arnavwx/Analog-Quadrature-Down-Converter/docs/images/lab_pictures/06_Oscillator_Output_Lab.png

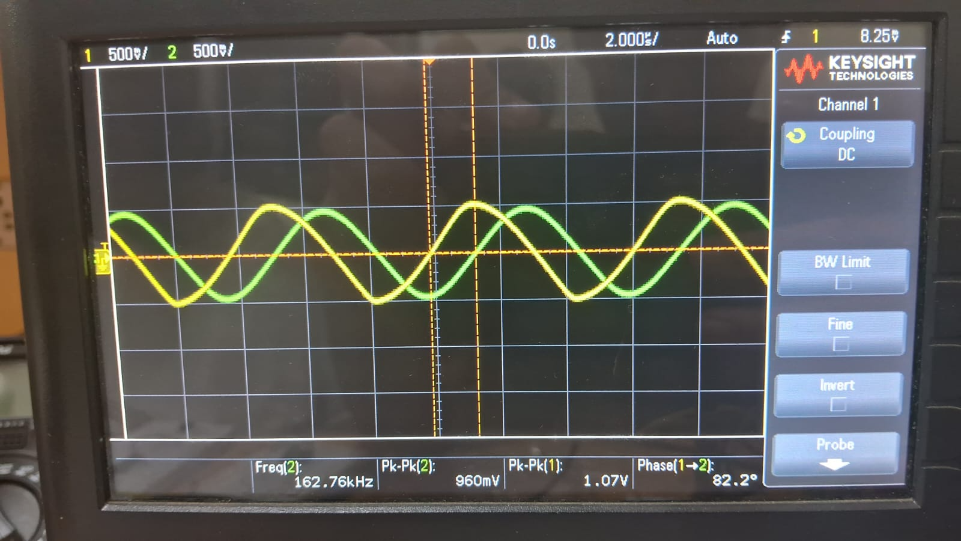
docs/images/lab_pictures/06_Oscillator_Output_Lab.png
