arnavwx/Analog-Quadrature-Down-Converter/theory/01_Direct_Conversion_Architecture.md

# Direct-Conversion (Zero-IF) Architecture

## Overview
The Direct-Conversion Receiver (DCR), also known as Homodyne, Zero-IF, or Synchrodyne architecture, is a radio receiver design that demodulates an incoming radio frequency (RF) signal using a local oscillator (LO) whose frequency is identical (or very close) to the carrier frequency of the intended signal.

Unlike a Superheterodyne receiver, which steps down the high-frequency RF signal into an intermediate frequency (IF) before baseband processing, a Direct-Conversion receiver translates the RF signal directly down to baseband (0 Hz) in a single step.

## Advantages of Direct Conversion
1. **No Image Frequency**: Because the IF is zero, the image frequency is the RF signal itself. This eliminates the need for bulky and expensive image-reject filters (IRF) placed before the mixer.
2. **High Integration**: All channel selection filters can be low-pass filters instead of band-pass filters. Low-pass filters are much easier to integrate onto a silicon CMOS chip, leading to highly miniaturized System-on-Chip (SoC) transceivers (like those in modern smartphones and IoT devices).
3. **Cost and Power Efficiency**: Removing the off-chip SAW filters and secondary IF stages significantly cuts down the bill of materials (BOM), manufacturing cost, and power consumption.

## Why Quadrature (I/Q) Downconversion?
When an RF signal is mixed directly down to 0 Hz, the upper and lower sidebands of the RF signal fold on top of each other at baseband. If the signal is phase- or frequency-modulated (e.g., QAM, QPSK), mixing with a single LO will irretrievably scramble the sidebands together, destroying the information.

To separate the sidebands, we must use **Quadrature Downconversion**. The RF signal is split and fed into two parallel mixers:
- **I (In-phase) Mixer**: Driven by $LO \cdot \cos(\omega t)$
- **Q (Quadrature) Mixer**: Driven by $LO \cdot \sin(\omega t)$ (a $90^\circ$ phase shift)

By processing both the I and Q channels, the digital backend (DSP) can perfectly reconstruct the complex signal vector and separate the folded sidebands.

## Key Design Challenges
1. **DC Offsets**: Since the signal is downconverted to DC (0 Hz), any LO leakage into the RF port that mixes with itself creates a massive DC spike. This can saturate the baseband amplifiers.
2. **I/Q Mismatch**: If the LO paths do not have exactly $90^\circ$ of phase shift, or if the two mixers have slightly different gains, the resulting constellation diagram will be distorted, degrading the Bit Error Rate (BER).
3. **Flicker Noise (1/f Noise)**: CMOS transistors exhibit high 1/f noise at low frequencies. Since the baseband signal sits near DC, it must compete with the high flicker noise of the mixer and subsequent amplifiers.
