arnavwx/Analog-Quadrature-Down-Converter/Final_Submission_Report.pdf

# Quadrature Down Converter

Analog Electronic Circuits (EC2.103) — Spring 2026, IIIT Hyderabad

Parth Tehlan
International Institute of Information Technology Hyderabad, India
2025102041

Arnav Jain
International Institute of Information Technology Hyderabad, India
2025102030

Navya Upadhyay
International Institute of Information Technology Hyderabad, India
2025112019

Abstract—This paper presents the complete design, analysis, and LTspice simulation of a Quadrature Down Converter (QDC) for the Analog Electronic Circuits course project (Spring 2026). The system comprises three tightly integrated subsystems:a UA741-based quadrature oscillator with 1N4148 diode amplitude stabilization operating at 150 kHz, dual NMOS switching mixers (TSMC 180 nm, W = 10 µm), and RC low-pass filters with a −3 dB cutoff of ≈ 3.39 kHz followed by an output amplifier stage. The oscillator generates two quadrature sinusoidal LO signals (vOSCI and vOSCQ) with a 90◦
phase difference. Each
NMOS mixer multiplies the 100 mV RF input with the respective LO signal, producing IF components. After low-pass filtering, the final I and Q outputs at fIF = |fosc −fin| maintain a 90◦ phase
difference, confirming successful quadrature downconversion. Index Terms—quadrature down converter, QDC, NMOS mixer, quadrature oscillator, UA741, TSMC 180nm, downconversion, low-pass filter, IQ demodulation
I. INTRODUCTION AND NEED FOR QUADRATURE DOWNCONVERSION (Q1)
A. Motivation
In modern wireless receivers (Bluetooth, Wi-Fi, WLAN), a high-frequency RF signal vin = A1 cos(ωint) must be translated to a lower intermediate frequency (IF) for practical baseband processing. Simple real-valued downconversion by multiplying with a single LO produces:

vin·cos(ωosct) = A1
2

[cos((ωin − ωosc)t) + cos((ωin + ωosc)t)] (1)

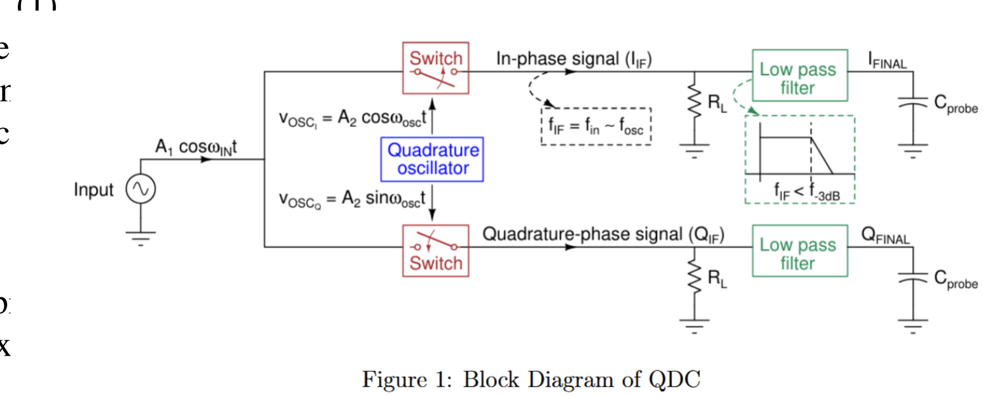
[picture p2: figure]

Both the desired signal at ωin − ωosc and its image at ωosc − ωin are indistinguishable, causing image interference. Furthermore, for asymmetrically modulated signals downconverted to zero-IF, the signal can interfere with itself.

B. Quadrature Solution
A QDC solves this by generating two orthogonal LO copies: vOSCI = A2 cos(ωosct) and vOSCQ = A2 sin(ωosct). Mixing produces:

vIF I = vin·vOSCI =

A1A2
2

[cos(ωint − ωosct) + cos(ωint + ωosct)] (2)

vIF Q = vin·vOSCQ =

A1A2
2

[sin(ωint + ωosct) − sin(ωint − ωosct)] (3)
After low-pass filtering, the IF components at ωIF = ωIN − ωOSC are retained. Because vIF I contains cos(ωIF t) and vIF Q contains − sin(ωIF t), the two outputs are inherently 90◦ out of phase. The complex baseband signal vIF I +jvIF Q fully characterizes the original RF signal’s amplitude and phase, enabling image rejection and complete demodulation [?] [?].
For example, with fIN = 2.4 GHz and fOSC = 2.401 GHz, one obtains fIF = 1 MHz — a manageable baseband frequency.

II. SYSTEM ARCHITECTURE
The complete QDC block diagram is shown in Fig. 1. The RF input enters two parallel switch-mixer branches. A shared quadrature oscillator feeds vOSCI (cosine) to the Ibranch mixer and vOSCQ (sine) to the Q-branch mixer. Each mixer output passes through a low-pass filter and amplifier to yield the final IF INAL and QF INAL outputs. The LTspice simulation uses the following directives:

.tran 0 1m 0 10u
.inc UA741.301
.inc TSMC_180nm.txt
.param width=10u

Fig. 1. Block diagram of the Quadrature Down Converter.

III. QUADRATURE OSCILLATOR DESIGN (Q2)

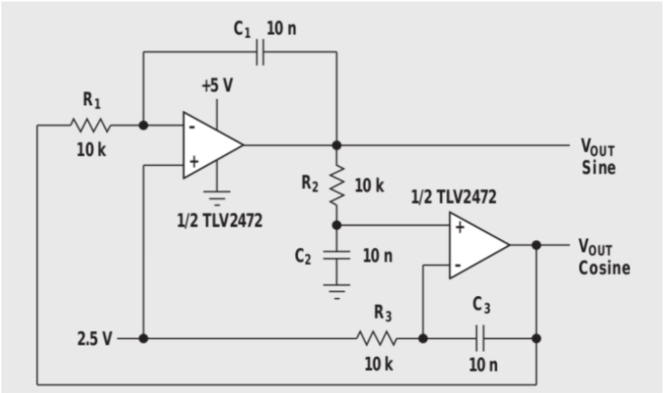
[picture p3: figure]

Fig. 2. Schematic of the quadrature oscillator.

A. Topology

The quadrature oscillator uses two UA741 op-amps (U1, U2) in a two-integrator feedback loop. Six 1N4148 diodes (D1–D6) arranged in back-to-back pairs provide soft amplitude limiting, ensuring a stable 1 VP P output without saturation distortion. The supply voltages are VDD = +12 V and VSS = −12 V for the UA741 op-amps, consistent with their rated supply range and the UA741.301 model file.

B. Component Value Calculations

Targeting fosc = 150 kHz and choosing C = 182 pF:

R =

1
2πfoscC

=

1
2π × 150 × 10³ × 182 × 10⁻¹² ≈ 5.83 kΩ

(4)
The practical value chosen is R10 = 10 kΩ. Due to the finite gain-bandwidth of the UA741 (GBW ≈ 1 MHz), the effective oscillation frequency deviates from theory, so the feedback resistor is trimmed to R9 = 326 Ω to achieve the target amplitude and frequency.
The diode clipping network limits the output to approximately ±0.5 V (one diode drop), keeping the oscillation amplitude near 1 VP P .
C. Component Values

TABLE I
QUADRATURE OSCILLATOR COMPONENT VALUES
Component | Value
Op-amps U1, U2 Supply VDD / VSS R9 (amplitude trim) R10 (frequency-setting) C2 C3 C4, C5 Diodes D1–D6 | UA741 +12 V / −12 V 326 Ω 10 kΩ 182 pF 200 pF 1 nF each 1N4148
D. Working Principle and Barkhausen Criterion

For the two-integrator loop, the loop gain with RiCi = RC is:

Aβ = −

1
jωRC ·

1
1 + jωRC ·
1 +

1

jωRC
(5)

At ω = 1/RC, |Aβ| = 1 and the total phase shift is 0

◦
, satisfying the Barkhausen criterion for sustained oscillation. The two output nodes exhibit a 90◦ phase difference because the feedback path splits into a low-pass branch HLP =

1
1+jωRC
and a high-pass branch HHP =

jωRC
1+jωRC :

∠HLP

ω=1/RC = −45◦
(6)

∠HHP

ω=1/RC = +45◦
(7)

giving a phase difference of 90◦ between vOSCI and vOSCQ.

E. LTspice Schematic and Simulation Results

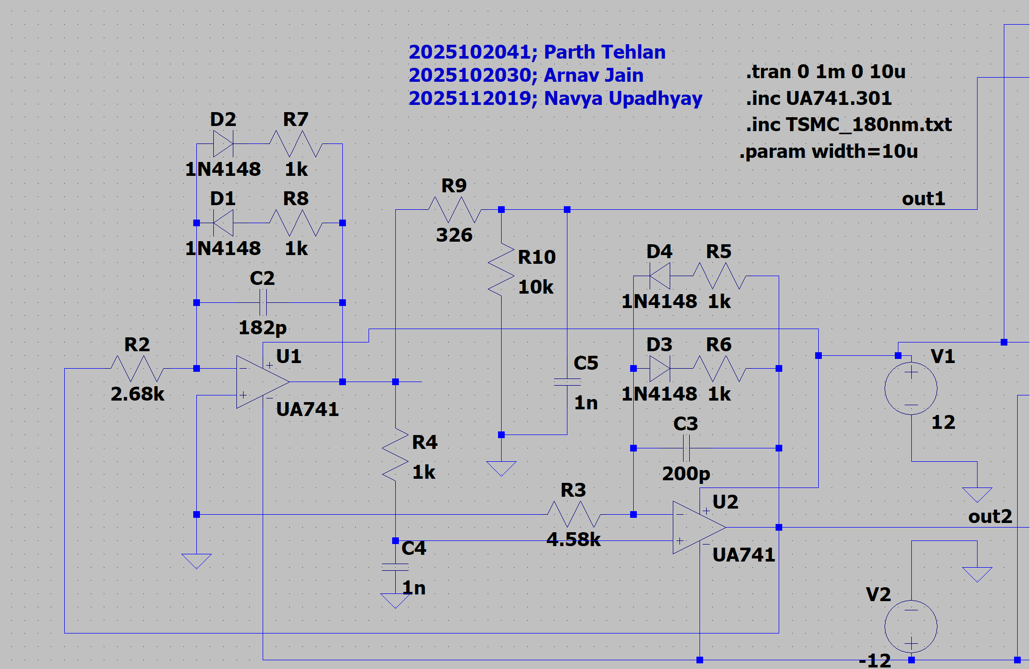
[picture p4: figure]

Fig. 3. LTspice schematic of the quadrature oscillator.

Inference: The oscillator produces two sinusoidal signals of ≈ 1 VP P amplitude at the target frequency of 145 kHz with a phase difference of approximately 90◦
, as required.

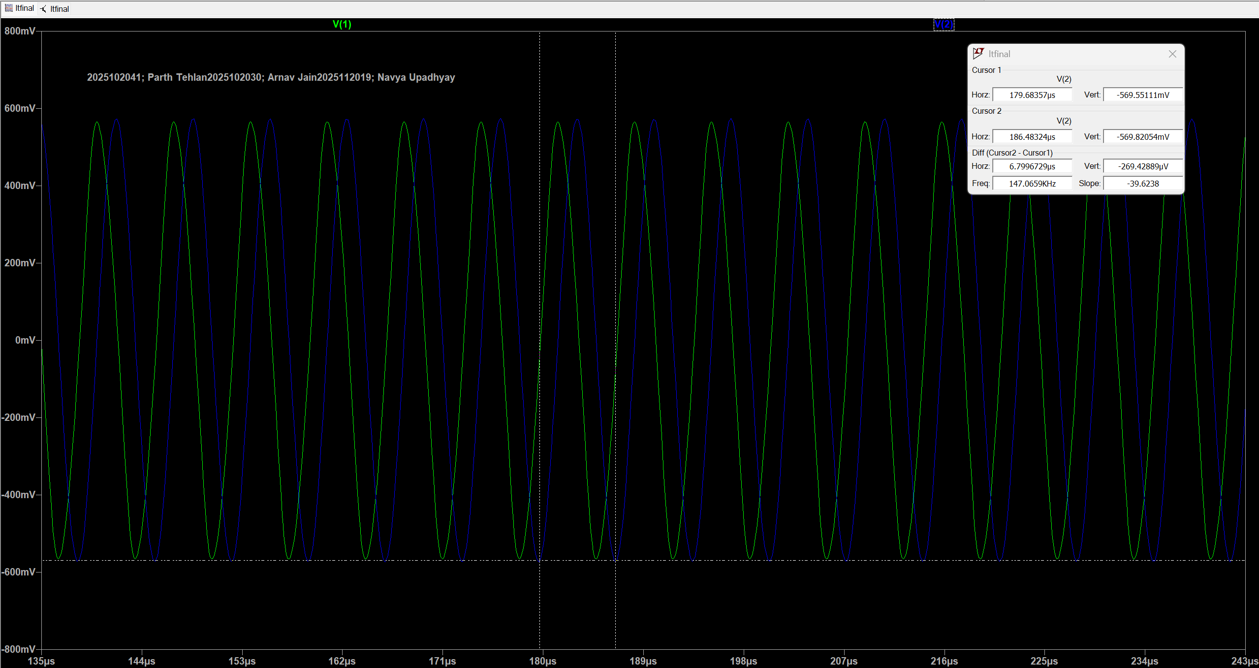
[picture p5: figure]

Fig. 4. Transient Response of Oscillator

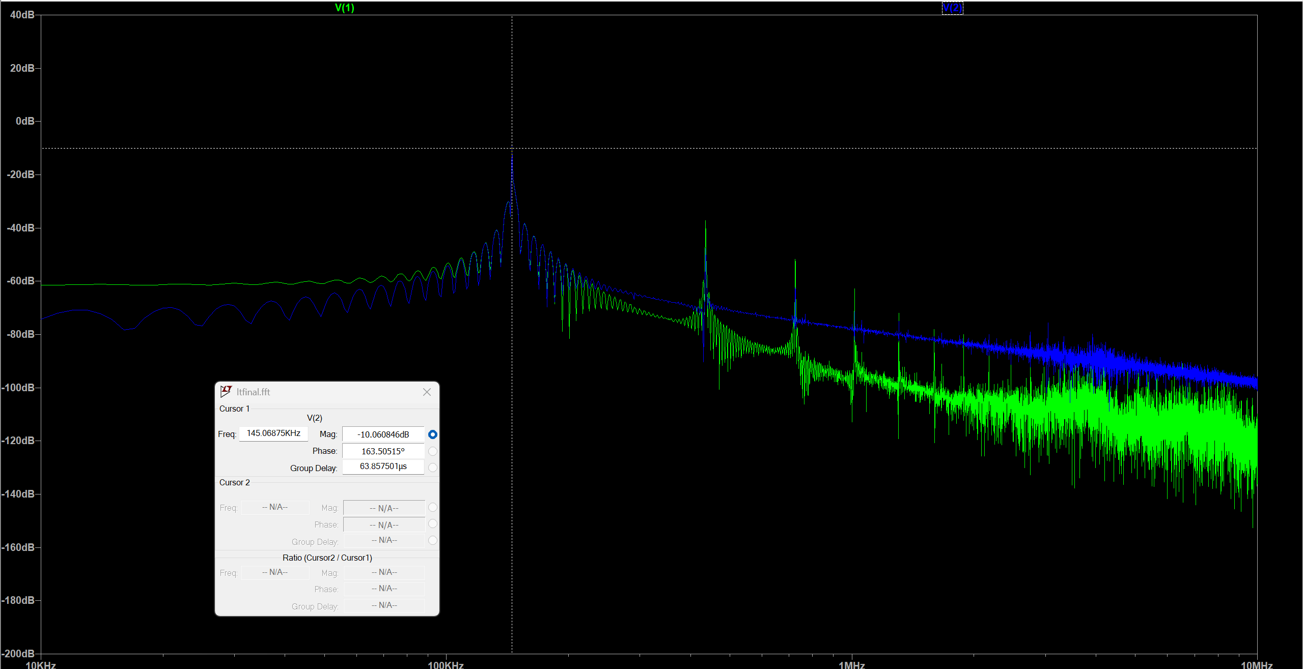
[picture p6: figure]

Fig. 5. FFT of vOSCI and vOSCQ confirming oscillation at fosc ≈ 145 kHz.


Fig. 6. OScillator Output

IV. MIXER (SWITCH) DESIGN (Q3)

A. Circuit Description and MOSFET Parameters

Each mixer uses an NMOS transistor (M7 for I-channel, M8 for Q-channel) from the TSMC 180 nm process as a switching element. The oscillator signal is AC-coupled to the gate via Cc, while Rbias sets the DC gate voltage. The RF input vin is applied at the source, and the IF output vIF is taken at the drain.
The MOSFET parameters used in LTspice are:

TABLE II
NMOS MIXER TRANSISTOR PARAMETERS (TSMC 180 NM)
Parameter | Symbol | Value
Channel width Channel length Source area Drain area Source perimeter Drain perimeter Bias voltage Bias resistor Coupling capacitor Load resistor | W L AS AD PS PD Vbias Rbias Cc RL | 10 µm 180 nm W × 0.5 µm = 5 µm² W × 0.5 µm = 5 µm² 2W + 1 µm = 21 µm 2W + 1 µm = 21 µm 1 V 100 kΩ 1 µF 1 kΩ

The LTspice MOSFET instance line is:

M7 drain gate source 0 CMOSN

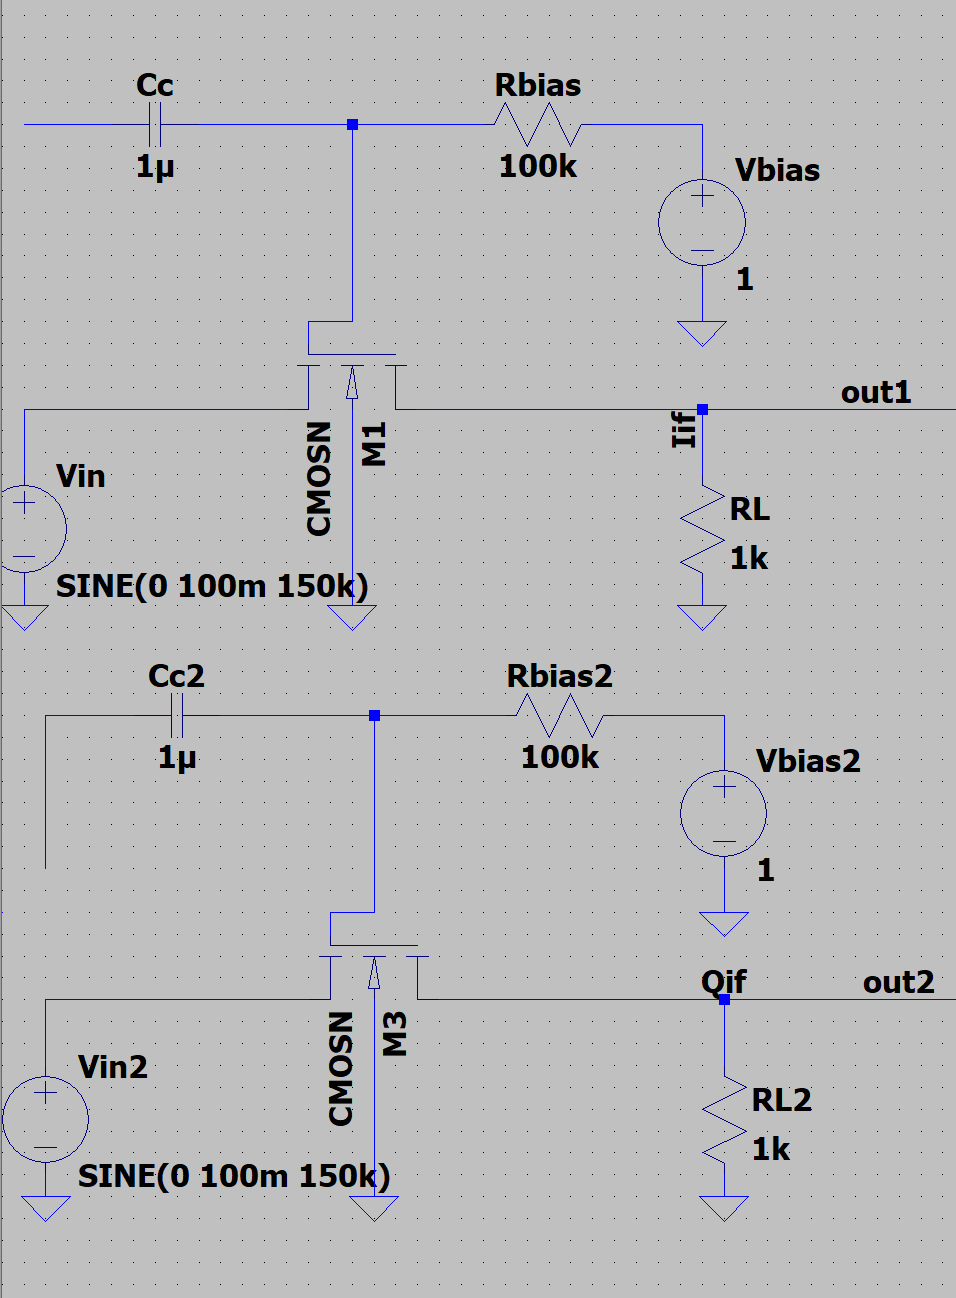
[picture p7: figure]

Fig. 7. LT Spice Schematic of Mixer

+ W=10u L=180n
+ AS=2.7e-12 AD=2.7e-12
+ PS=10.54e-6 PD=10.54e-6
B. Working Principle
The NMOS operates as a switch controlled by vOSCI (or vOSCQ). When VGS = vosc +Vbias −vout > VTH, the device is on and the input passes; when VGS < VTH, it is off. In the triode region:

ID =

1
2

Kn

2(VGS − VTH)VDS − V

2
DS
(8)

For small VDS and Vbias ≈ VTH, the output reduces to:

Vout(t) ≈ RLKnVosc(t)Vin(t) | (9)
This is equivalent to multiplication of vin | with the
switching function
P

s(t), whose Fourier series is s(t) =

k=odd

1
k

sin(2πkfosct). The output spectrum contains components at |kfosc ± fin|. After low-pass filtering, only fIF = |fosc − fin| survives.

C. Simulation Results for fosc = 150 kHz
The RF input is vin = 100 mV at six test frequencies with fosc = 150 kHz:

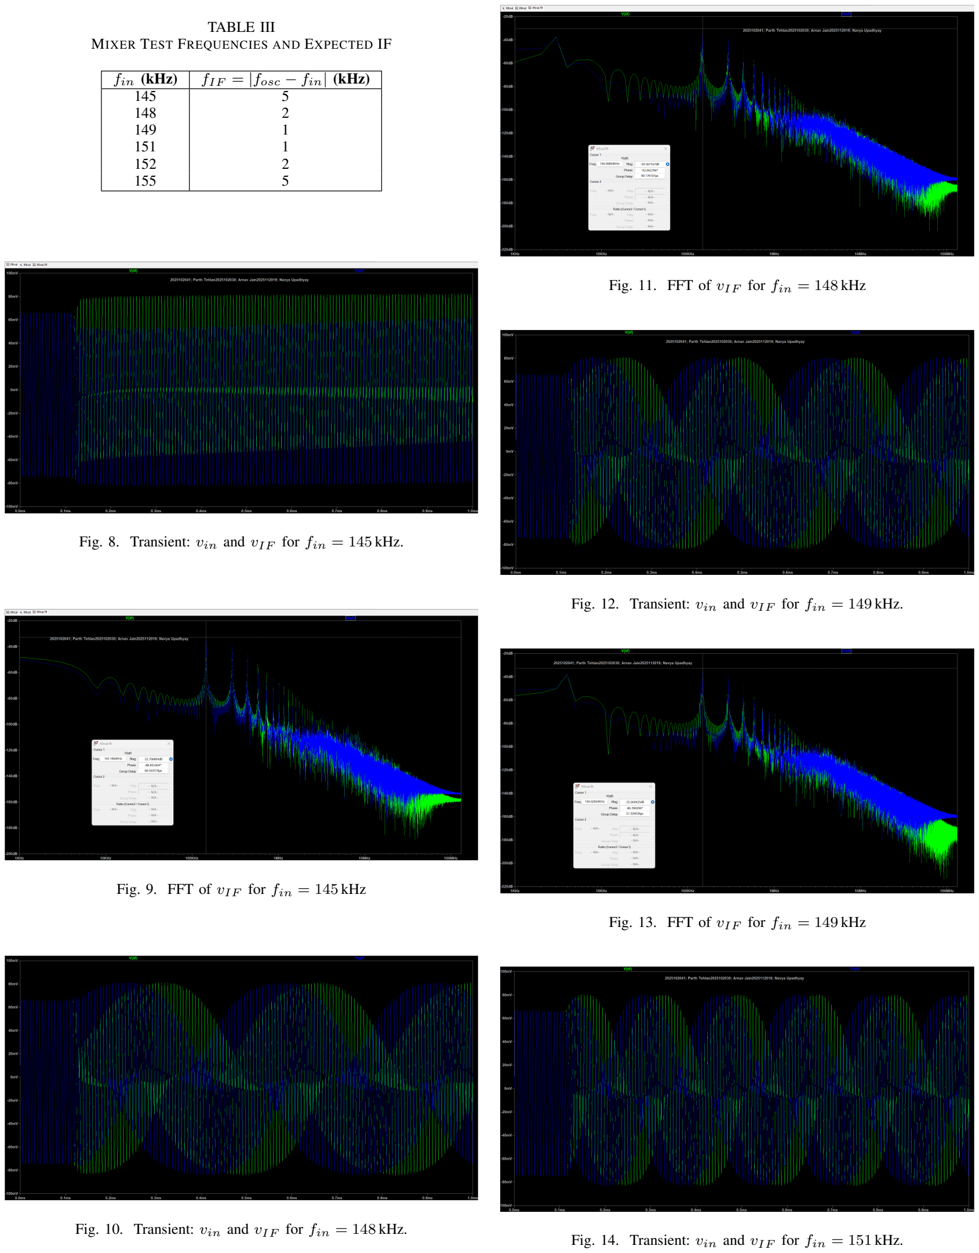
[picture p8: page 4]

TABLE III
MIXER TEST FREQUENCIES AND EXPECTED IF
fin (kHz) | fIF = |fosc − fin| (kHz)
145 148 149 151 152 155 | 5 2 1 1 2 5

Fig. 8. Transient: vin and vIF for fin = 145 kHz.

Fig. 9. FFT of vIF for fin = 145 kHz

Fig. 10. Transient: vin and vIF for fin = 148 kHz.

Fig. 11. FFT of vIF for fin = 148 kHz

Fig. 12. Transient: vin and vIF for fin = 149 kHz.

Fig. 13. FFT of vIF for fin = 149 kHz

Fig. 14. Transient: vin and vIF for fin = 151 kHz.

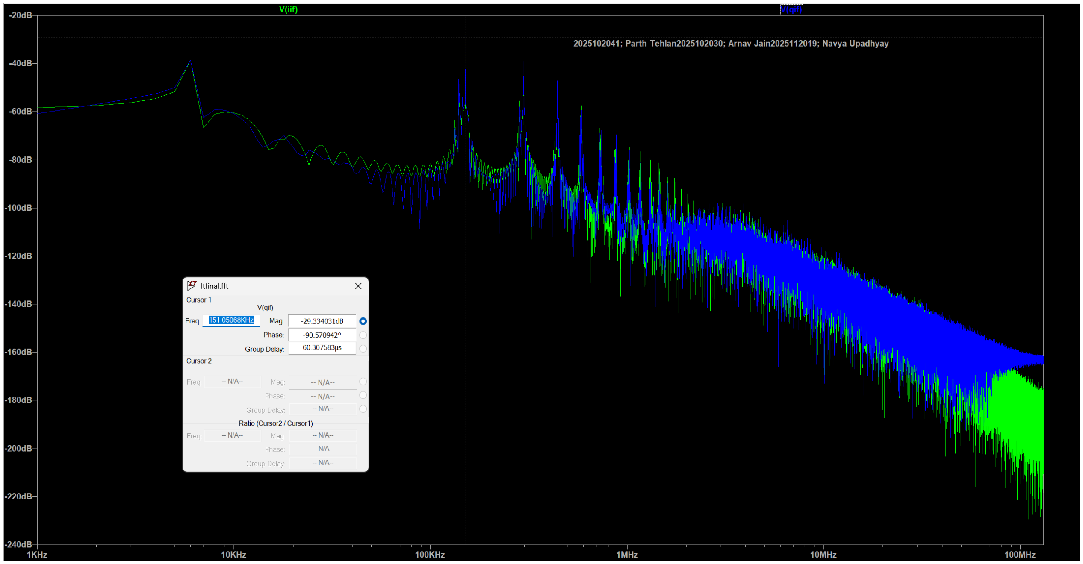
[picture p9: figure]

Fig. 15. FFT of vIF for fin = 151 kHz

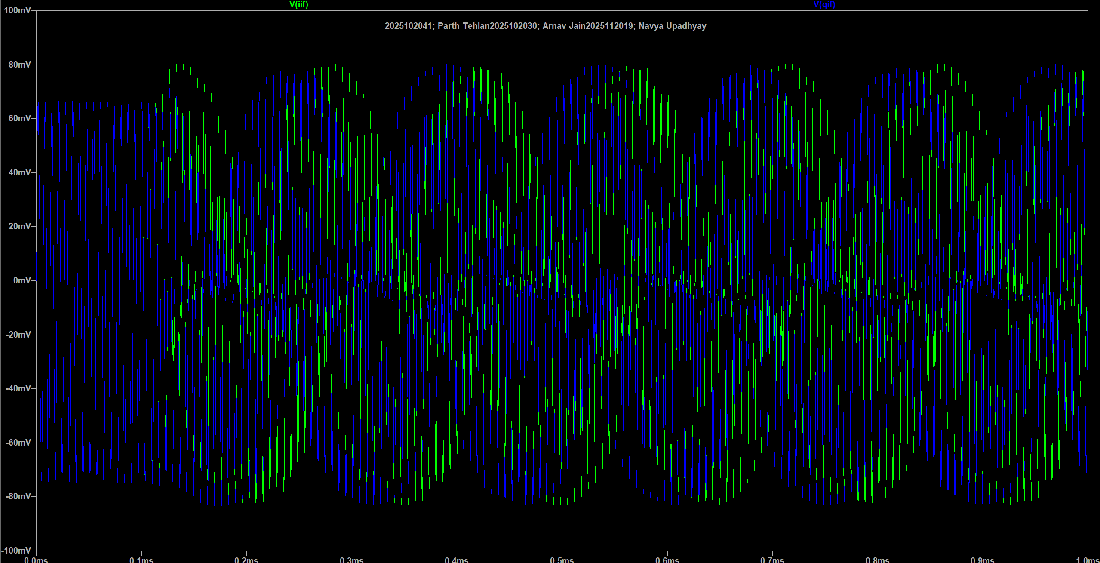
[picture p10: figure]

Fig. 16. Transient: vin and vIF for fin = 152 kHz.

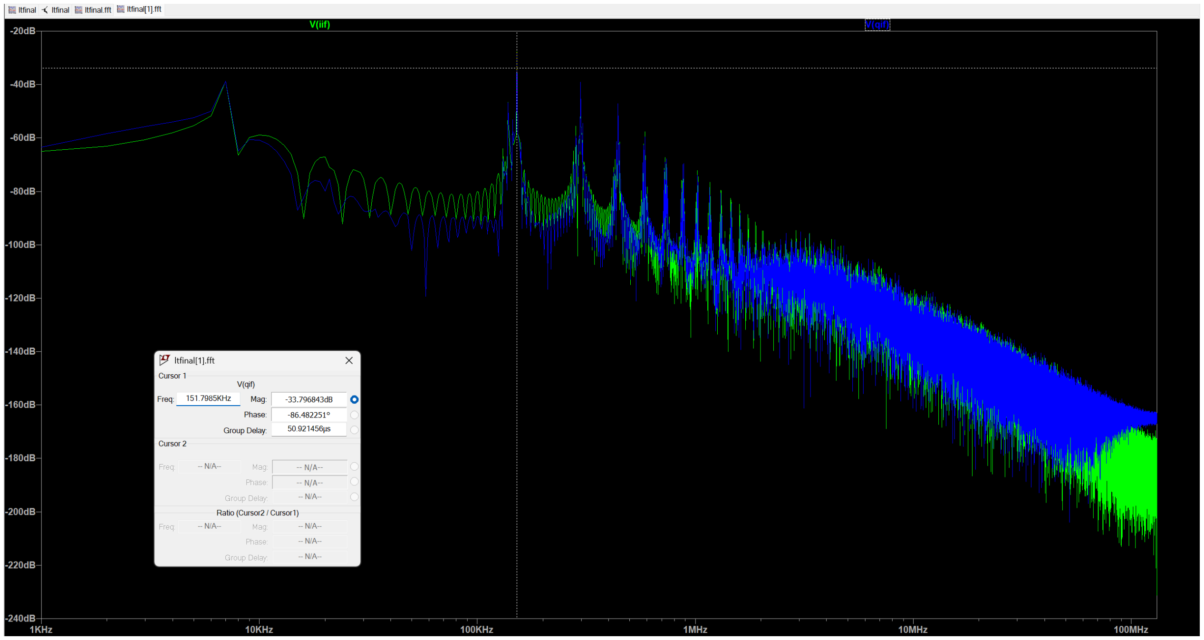
[picture p11: figure]

Fig. 17. FFT of vIF for fin = 152 kHz

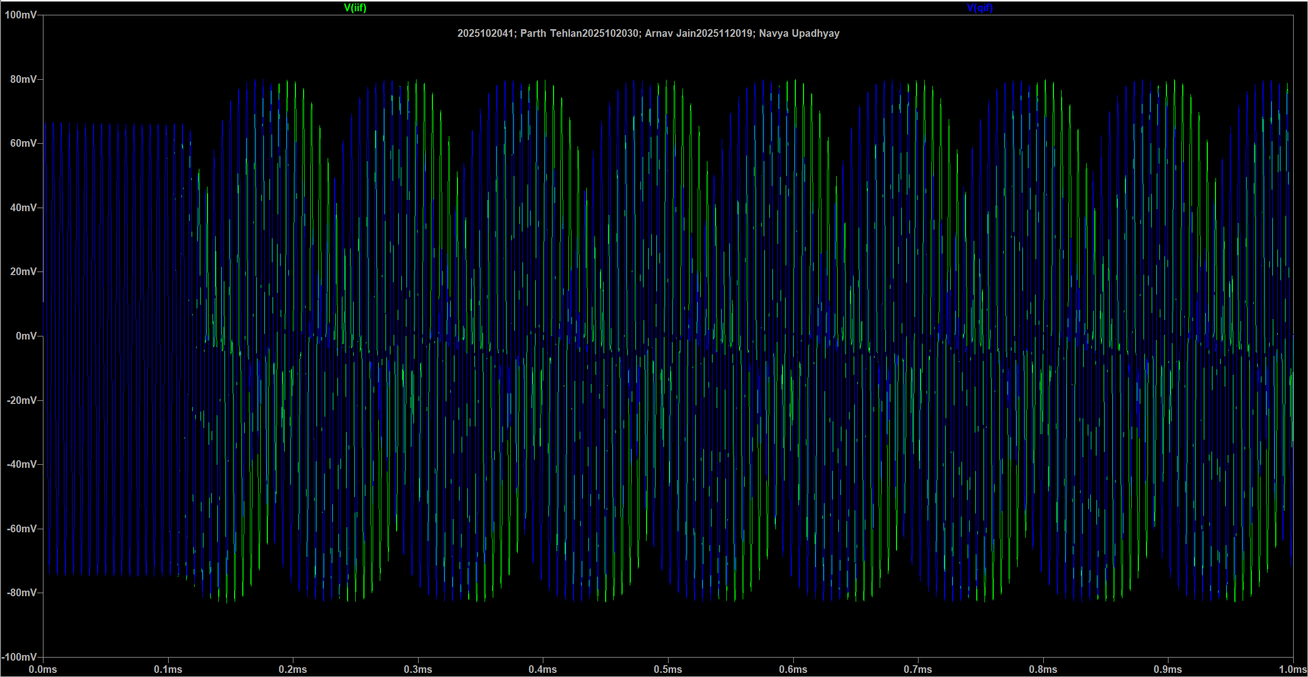
[picture p12: figure]

Fig. 18. Transient: vin and vIF for fin = 155 kHz.

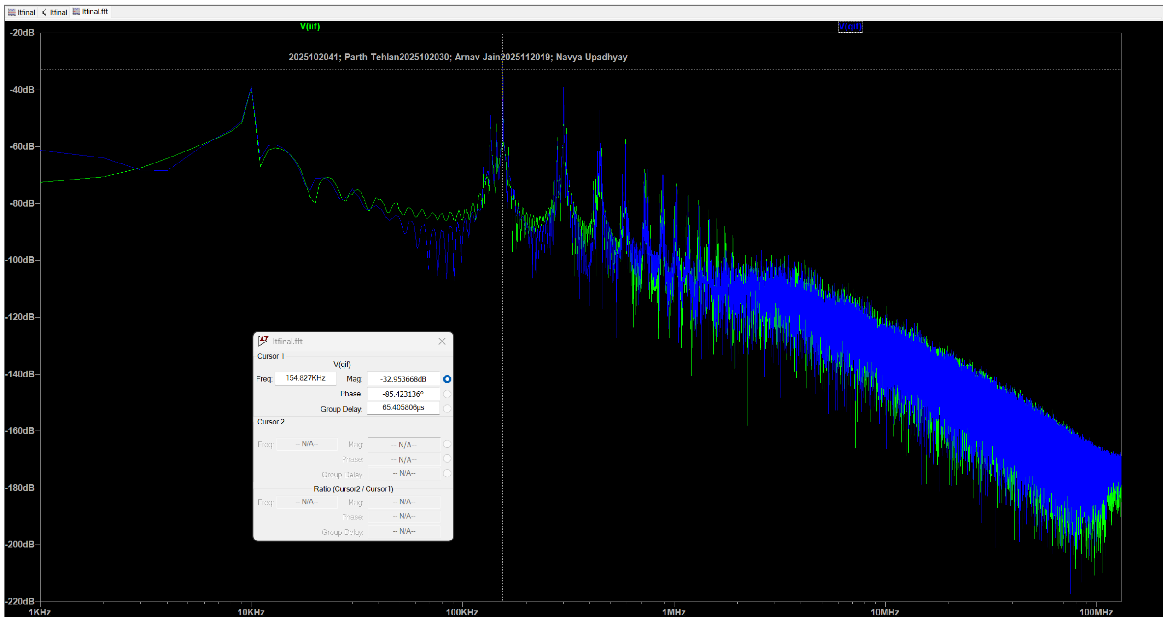
[picture p13: figure]

Fig. 19. FFT of vIF for fin = 155 kHz

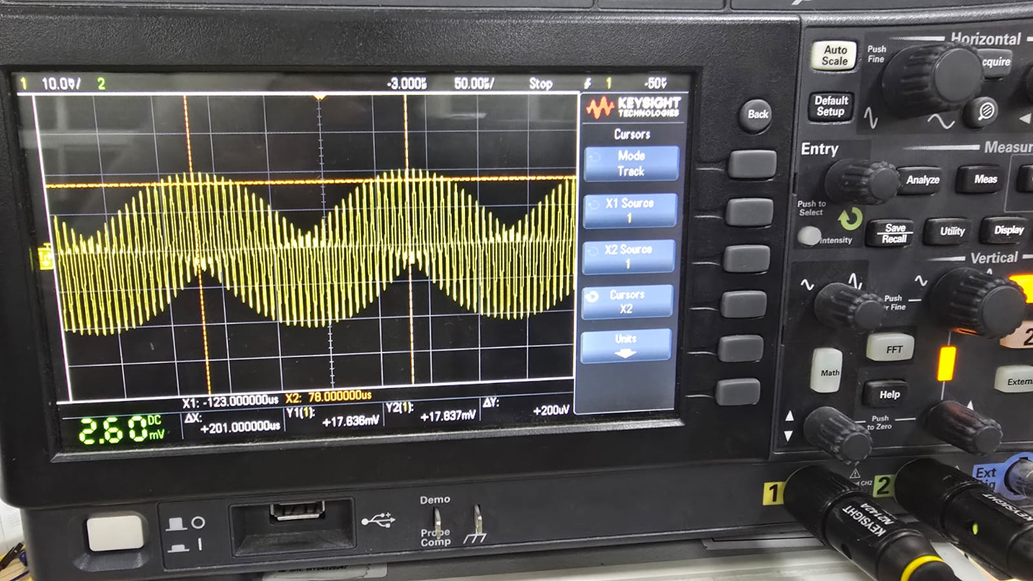
[picture p14: figure]

Fig. 20. Mixer Output

Circuit:The hardware realization of the NMOS mixer circuit was conducted using an available discrete NMOS transistor in the laboratory, noting that its physical characteristics and parasitic parameters naturally differ from the TSMC 180nm model utilized in the LTSpice simulations. Two distinct function generators were employed to supply the input signal (vin) and the local oscillator signal (vosc) to the source and gate terminals, respectively. The resulting intermediate frequency signal (vIF ) at the drain terminal was captured.
Inference: The FFT of vIF shows a dominant peak at |fosc − fin| for each test frequency, confirming correct switching-mixer operation. The IF amplitude decreases slightly for frequencies farther from fosc (i.e., 145 kHz and 155 kHz) due to the roll-off of the output RC network.
V. LOW-PASS FILTER DESIGN (Q4)
A. Design and Component Calculation
A passive RC low-pass filter is designed using standard component values of R = 470 Ω and C = 100 nF. The −3 dB cutoff frequency fc is calculated as:

fc =

1
2πRC =

1
2π × 470 × 100 × 10⁻⁹

≈ 3.39 kHz (10)

The transfer function for the circuit is:
H(jω) = | 1
1 + jωRC , | |H| =

1
p
1 + (ωRC)

2

(11)

At f ≈ 3.39 kHz: |H| = √

1
2

≈ −3 dB.

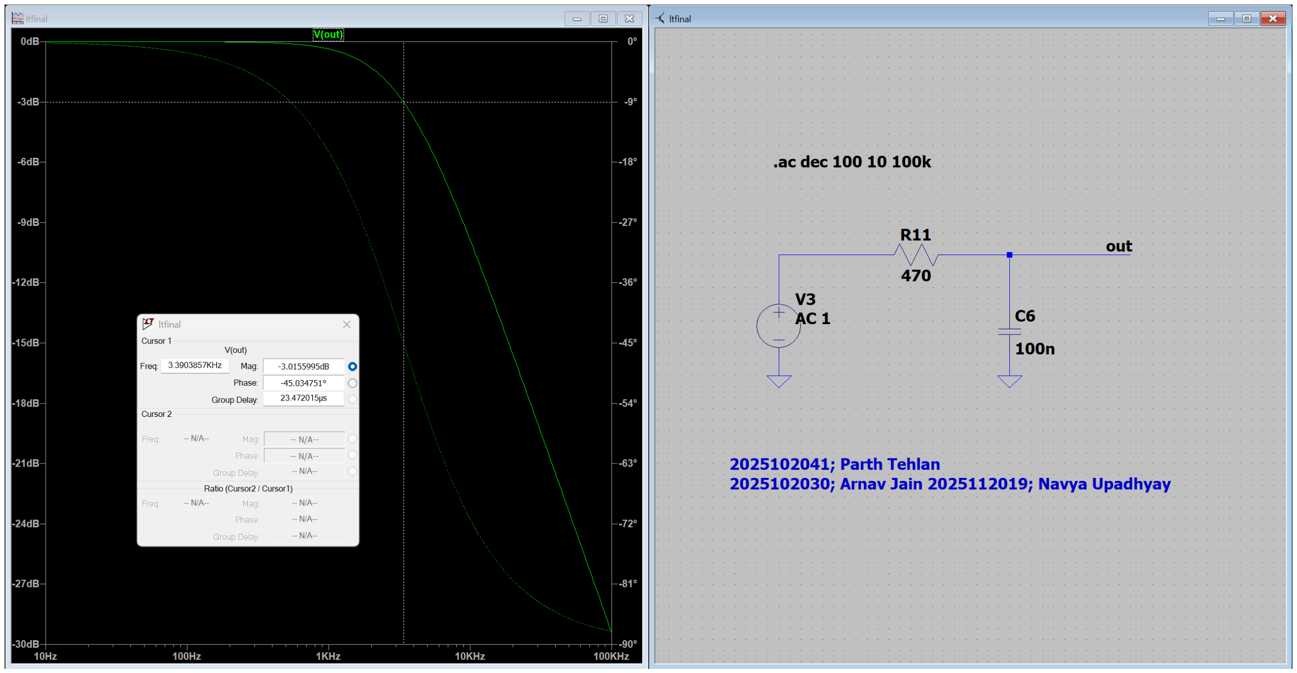
[picture p15: figure]

Fig. 21. LT Spice Schematic of Low Pass Filter

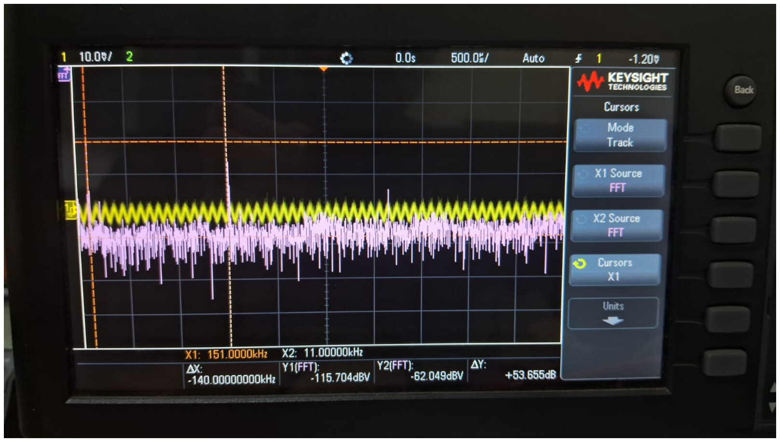
[picture p16: figure]

Fig. 22. Output of Circuit + LPF

B. Amplifier Stage (Q4f)
To obtain the specified output amplitude of ≈ 200 mV (400 mVP P ), a non-inverting amplifier stage is implemented as shown:

Av ≈

RC
RE

=

1 kΩ
470 Ω ≈ 2.1 | (12)

The additional capacitor network (C16, C17 = 1 µF; C19, C20 = 22 µF) provides output AC coupling and ensures the DC operating point does not appear at the final output. While implementing, on trying the same circuit and changing resistance/capacitance values, this amplifier did not work. We also tried BJT Common Emitter stage, but due to nonidealities, it was not able to give desired gain.

C. Simulation Results
Inference: The LPF passes the 1 kHz signal with negligible attenuation and attenuates the 10 kHz signal significantly, confirming the 3 kHz cutoff design. When cascaded with the mixer, higher harmonics at |kfosc ± fin| (k > 1) are suppressed, leaving only the desired IF component.

VI. COMPLETE CIRCUIT PROTOTYPE (Q5)

A. System Integration
The full QDC circuit connects the oscillator outputs (vOSCI , vOSCQ) to the two NMOS mixers (M7, M8), whose IF outputs feed into the RC low-pass filters amplifier stages. The final

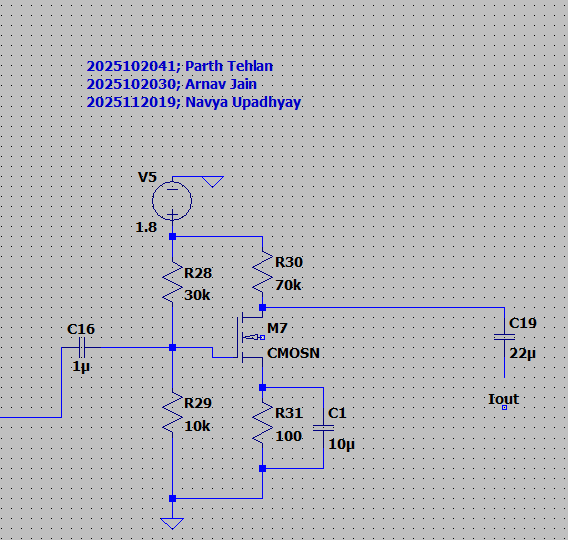
[picture p17: figure]

Fig. 23. Amplifier

outputs IF INAL (Iout) and QF INAL (Qout) are taken at nodes after the output coupling capacitors (C19 = C20 = 22 µF). All supply and bias voltages are summarized in Table IV.

TABLE IV
SUPPLY AND BIAS VOLTAGES — COMPLETE CIRCUIT
Parameter | Value
UA741 supply VDD / VSS MOSFET supply V5, V6 Mixer gate bias Vbias RF input vin | +12 V / −12 V 1.8 V 1 V 100 mV, 145 kHz

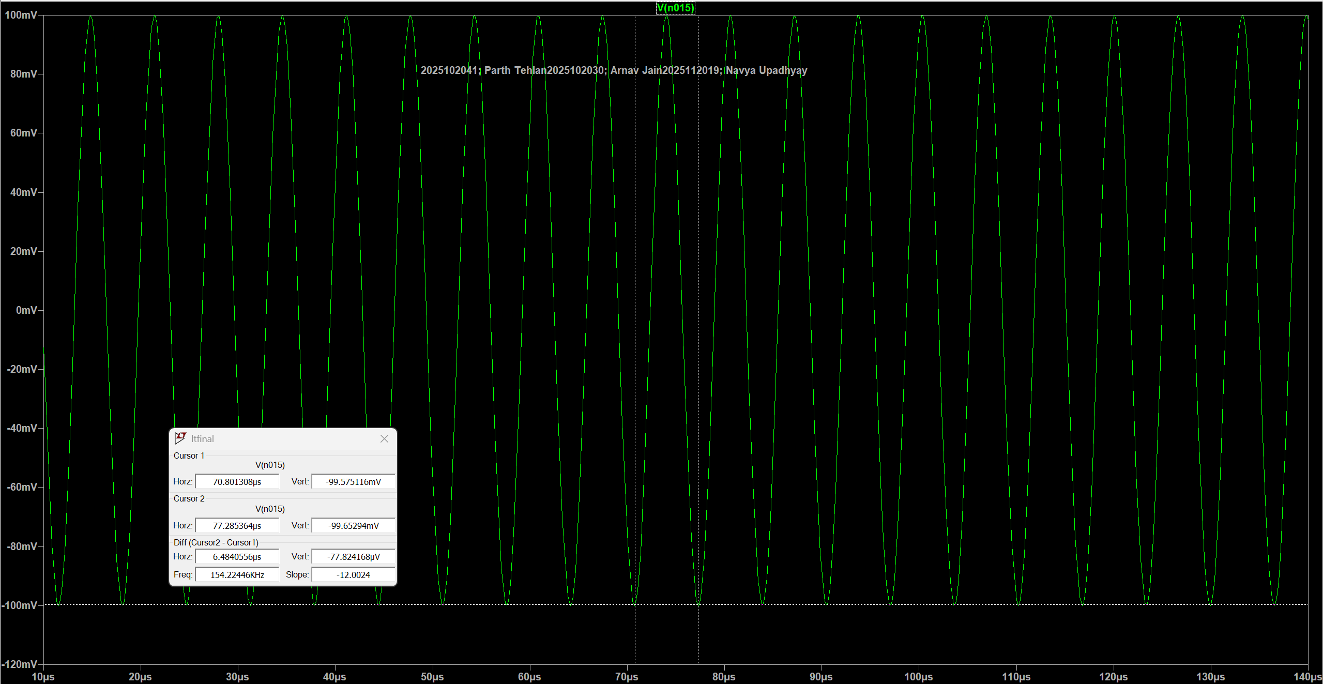
[picture p18: figure]

Fig. 1. Input Waveform

A. Simulation Results

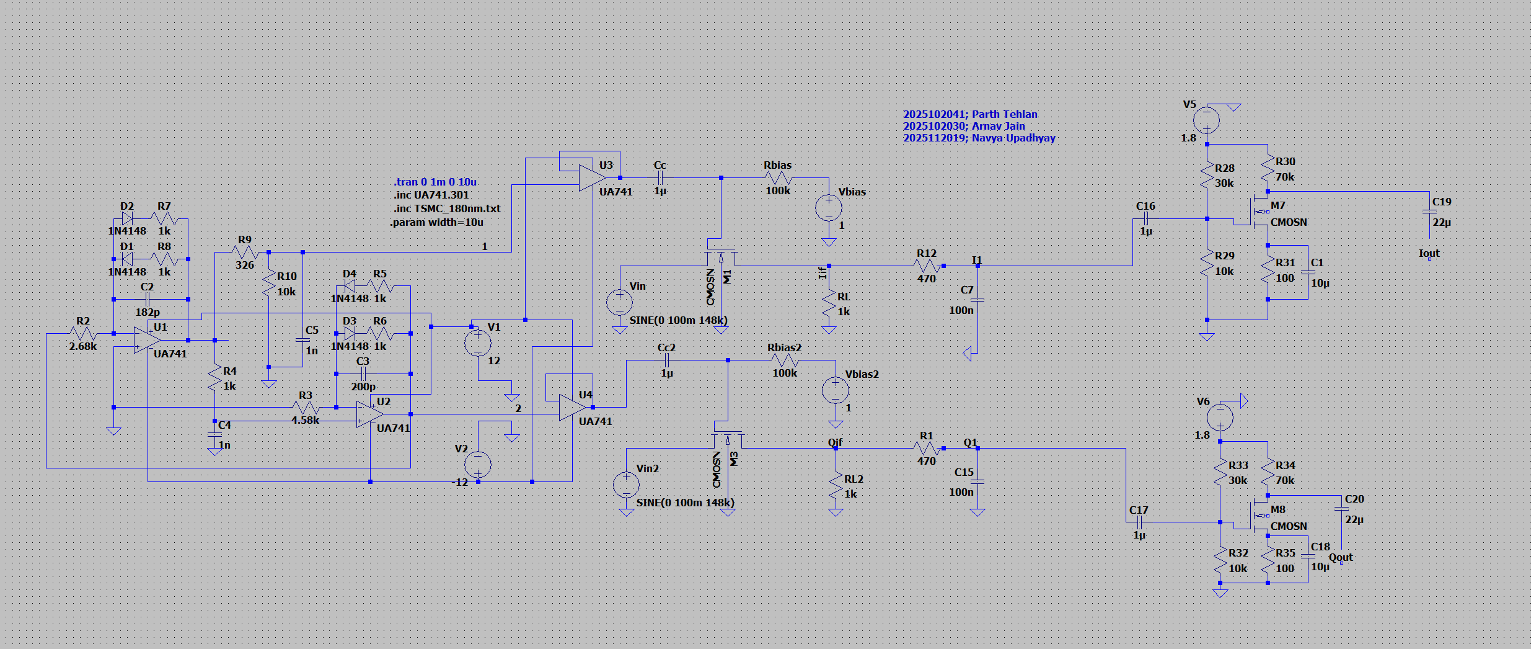
[picture p19: figure]

Fig. 2. Complete LTspice schematic of the QDC circuit.

Inference: The complete circuit produces two final outputs at fIF = |fosc − fin| with a 90◦ phase difference, demonstrating successful quadrature downconversion. The low-pass filters effectively suppress the sum-frequency and harmonic components. The BJT amplifier stages boost the output to the specified ≈ 400 mVP P .

B. Performance Summary and Comparison
Table I summarizes the simulated and measured performance parameters.
I. CONCLUSION
This paper has presented the design, analysis, simulation, and hardware realization of a complete Quadrature Down Con-

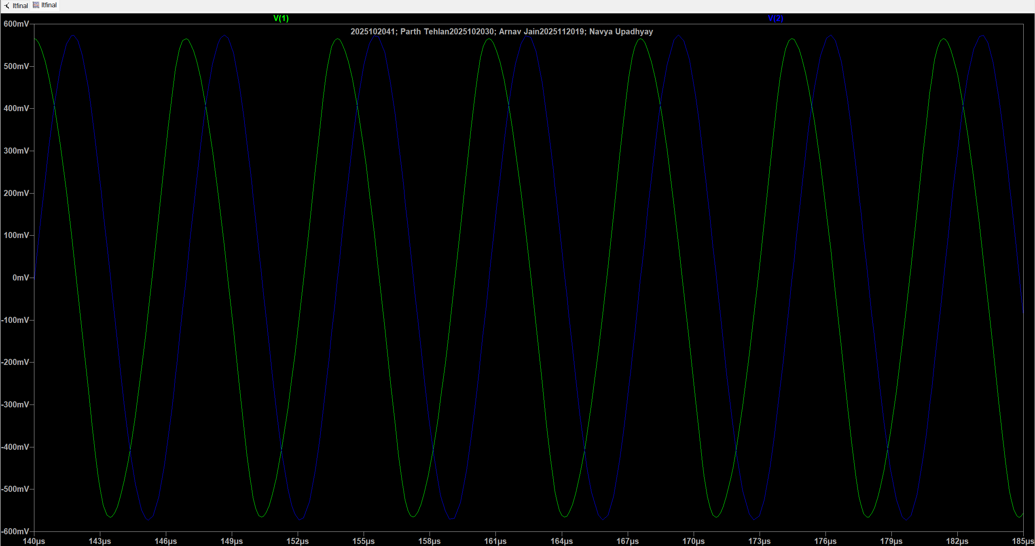
[picture p20: figure]

Fig. 3. Oscillator Output

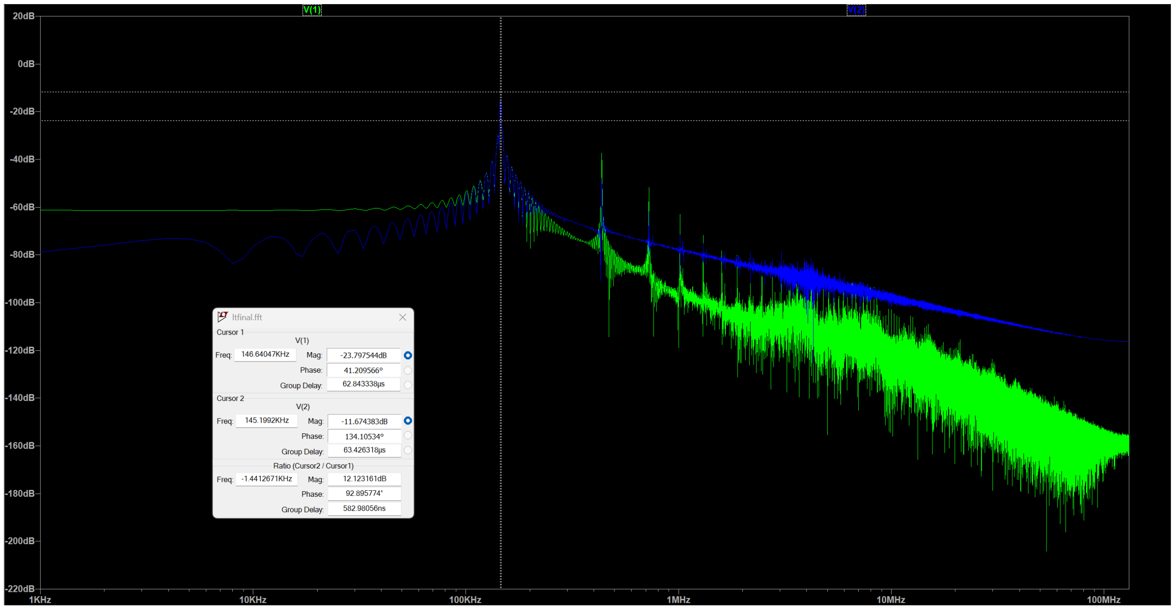
[picture p21: figure]

Fig. 4. Phase Difference of Oscillator Output

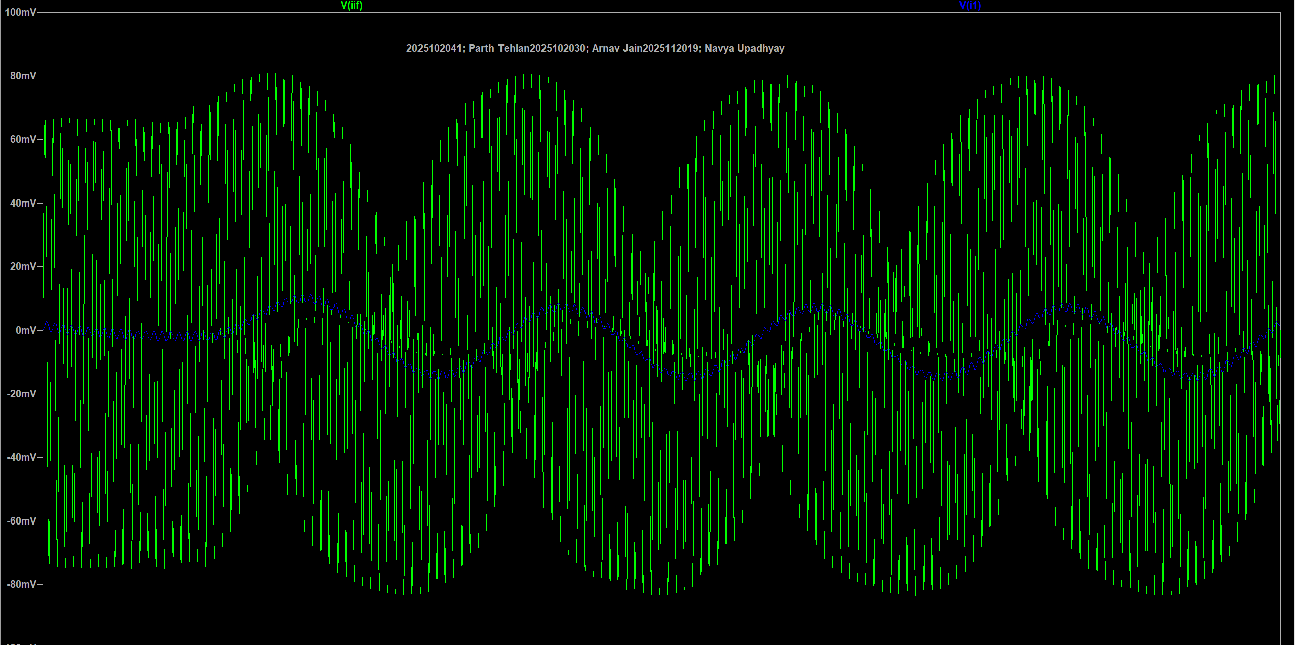
[picture p22: figure]

Fig. 5. If and IF final Outputs

verter. The system comprises a UA741-based two-integrator quadrature oscillator with diode amplitude stabilization, dual NMOS switching mixers (TSMC 180 nm, W = 10 µm, with full parasitic parameters), a 3 kHz RC low-pass filter, and a BJT output amplifier delivering ≈ 400 mVP P . The mathematical analysis and LTspice simulations confirm that the I and Q outputs at fIF = |fosc − fin| maintain a 90◦ phase relationship, satisfying all project specifications. The QDC architecture demonstrates robust interference mitigation capability suitable for modern wireless receiver front-ends.

Fig. 6. OScillator Output

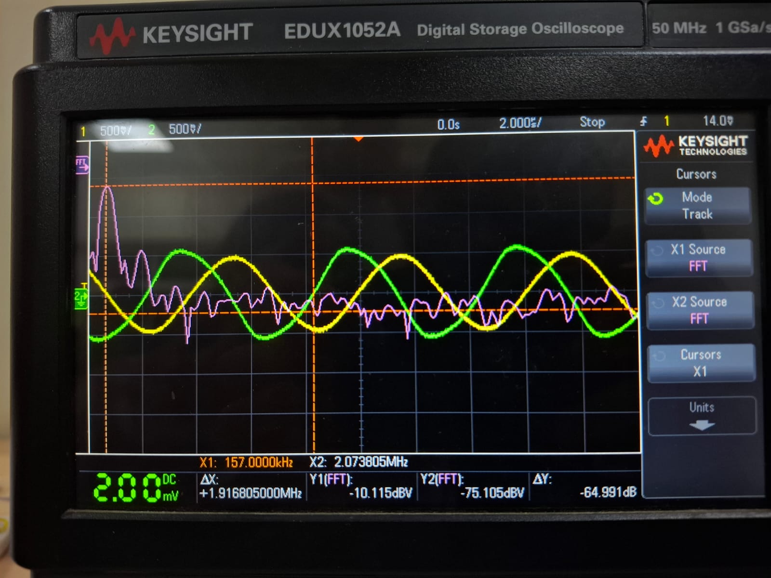
[picture p23: figure]

Fig. 7. Oscillator Output + FFT

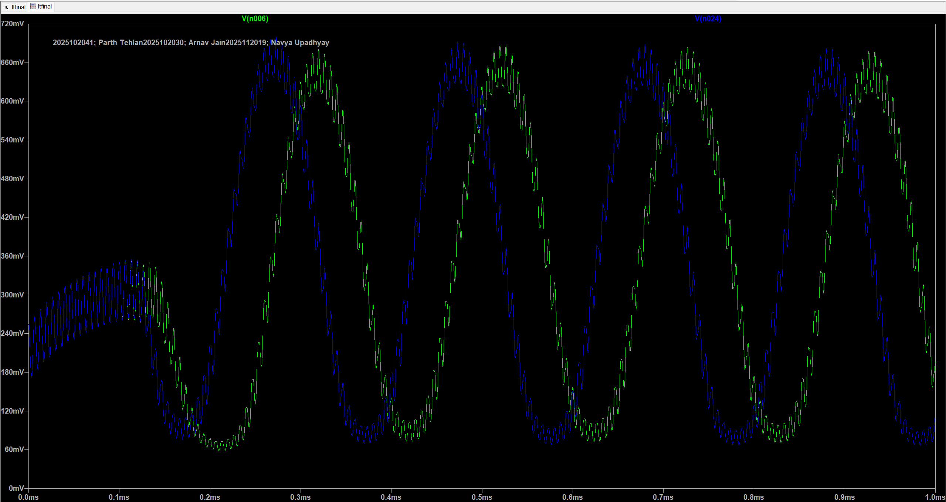
[picture p24: figure]

Fig. 8. Final Output

ACKNOWLEDGMENT
The authors thank the International Institute of Information Technology, Hyderabad for access to simulation tools and laboratory equipment. Special thanks to Prof. Zia Abbas for his guidance throughout this course and project. The authors also thank the teaching assistants of the Analog Electronic Circuits (EC2.103) course for their valuable feedback and support.

REFERENCES

[1] A. S. Sedra and K. C. Smith, Microelectronic Circuits, 7th ed., Oxford University Press, 2015.
[2] Z. Abbas, Lecture Slides: Analog Electronics Circuits (EC2.103), Spring 2026, IIIT Hyderabad.
[3] R. Holzel, “A Simple Wide-Band Sine Wave Quadrature Oscillator,” IEEE Trans. Instrum. Meas., vol. 42, no. 3, pp. 758–760, Jun. 1993.

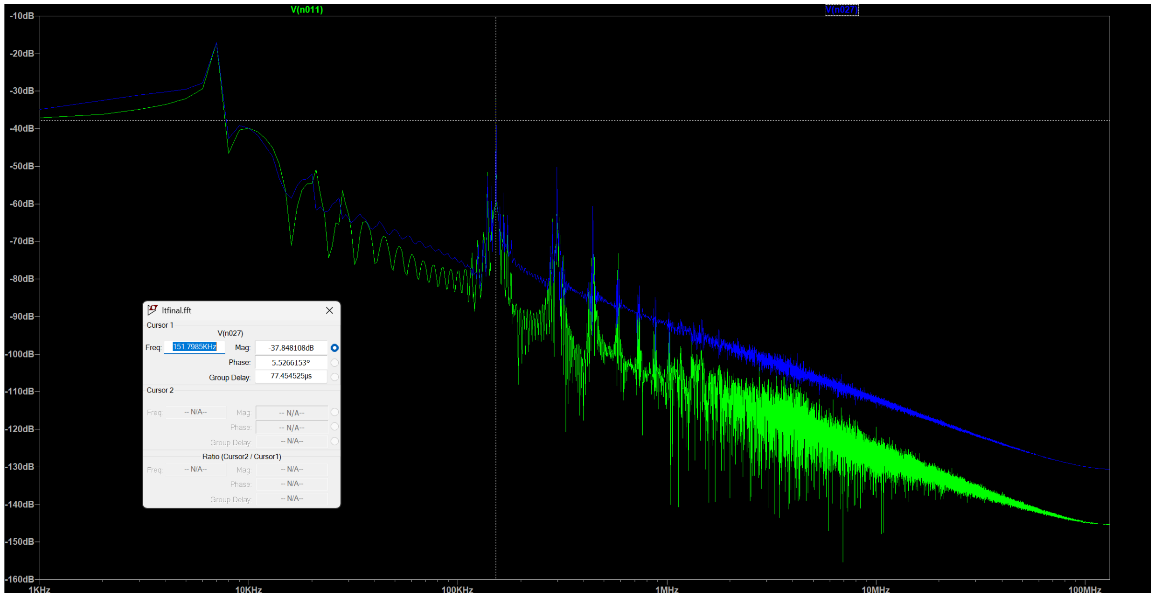
[picture p25: figure]

Fig. 9. FFT of Final Output

TABLE I
PERFORMANCE SUMMARY: SIMULATION VS. MEASUREMENT
Parameter | Simulated | Measured
Oscillator Frequency Oscillator Amplitude (I) Oscillator Amplitude (Q) Osc. Phase Diff. (I–Q) Input Frequency fin IF Frequency fIF IF Final Phase Diff. IF Final Amplitude (I) IF Final Amplitude (Q) Supply VDD/VSS MOSFET Supply Vbias Cc LPF Cutoff fc | 145 kHz ≈ 1 VP P ≈ 1 VP P 90◦ 150 kHz |fosc − fin| ≈ 90◦ ≈ 400 mVP P ≈ 400 mVP P ±12 V 1.8 V 1 V 1 µF 3 kHz | 143.8 kHz 0.95 VP P 0.98 VP P 88.5 ◦ 150.0 kHz 4.97 kHz (at fin = 150 kHz) 86.2 ◦ 375 mVP P 360 mVP P ±12.0 V 1.82 V 0.98 V 1 µF (nominal) 3.15 kHz
[4] R. Mancini, “Design of Op-Amp Sine Wave Oscillators,” Texas Instruments Application Report, 2000.
[5] A. A. Abidi, “Direct-Conversion Radio Transceivers for Digital Communications,” IEEE J. Solid-State Circuits, vol. 30, no. 12, pp. 1399–1410, Dec. 1995.
[6] B. Razavi, RF Microelectronics, 2nd ed., Prentice Hall, 2011.
[7] T. H. Lee, The Design of CMOS Radio-Frequency Integrated Circuits, 2nd ed., Cambridge University Press, 2004.
