arnavwx/Analog-Quadrature-Down-Converter/docs/images/lab_pictures/22_Circuit_LPF_Output_Lab.png

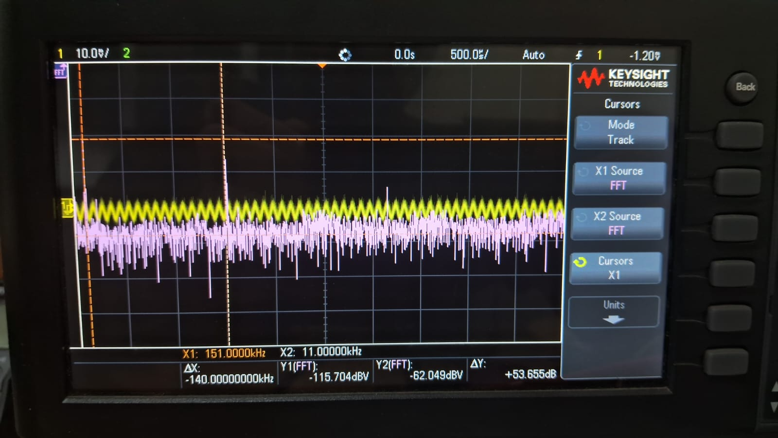
docs/images/lab_pictures/22_Circuit_LPF_Output_Lab.png
