arnavwx/Analog-Quadrature-Down-Converter/docs/images/ltspice_layouts/01_Block_Diagram.png

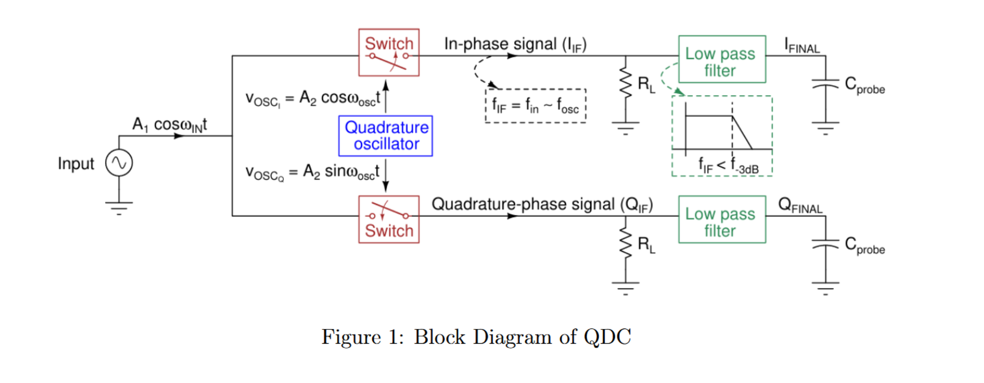
docs/images/ltspice_layouts/01_Block_Diagram.png
