arnavwx/Analog-Quadrature-Down-Converter/docs/images/ltspice_layouts/08_Transient_145kHz.png

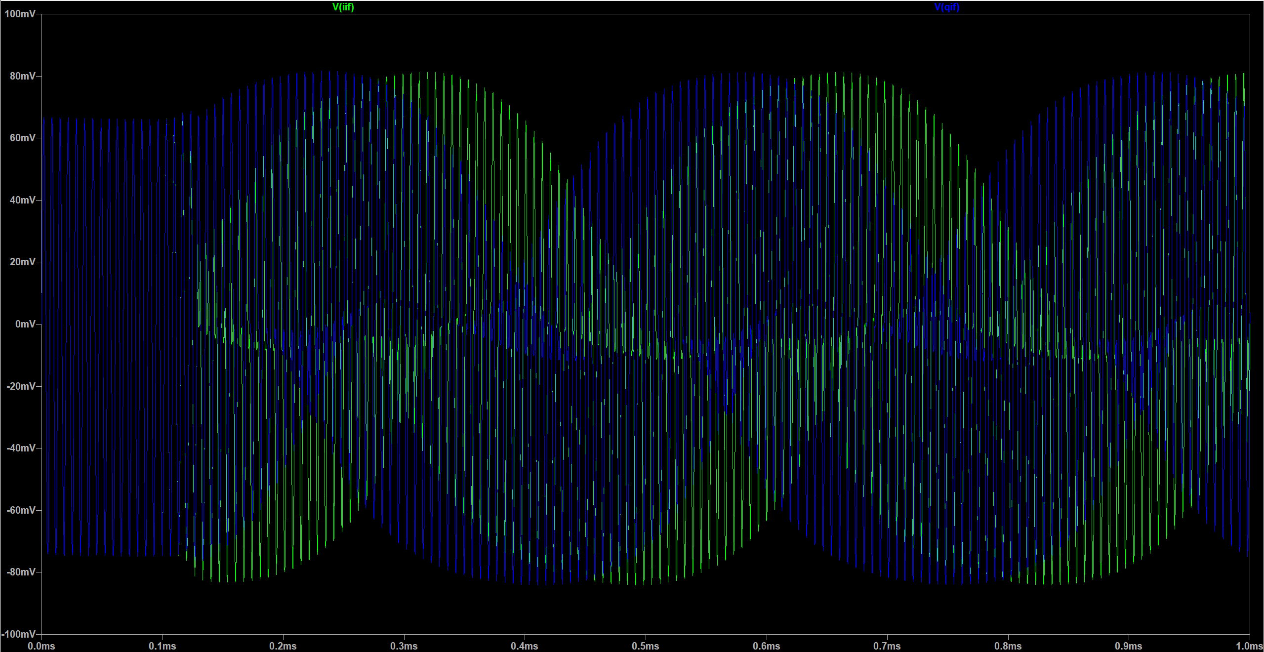
docs/images/ltspice_layouts/08_Transient_145kHz.png
