arnavwx/Analog-Quadrature-Down-Converter/docs/images/ltspice_layouts/09_FFT_145kHz.png

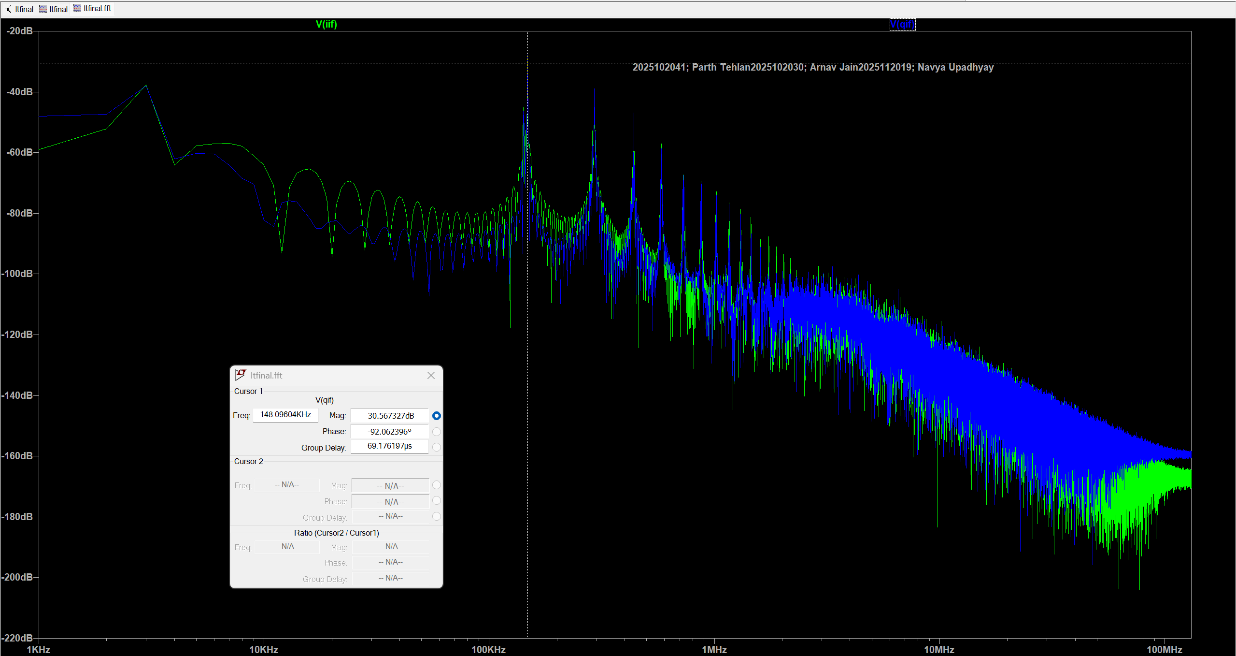
docs/images/ltspice_layouts/09_FFT_145kHz.png
