arnavwx/Analog-Quadrature-Down-Converter/docs/images/ltspice_layouts/10_Transient_148kHz.png

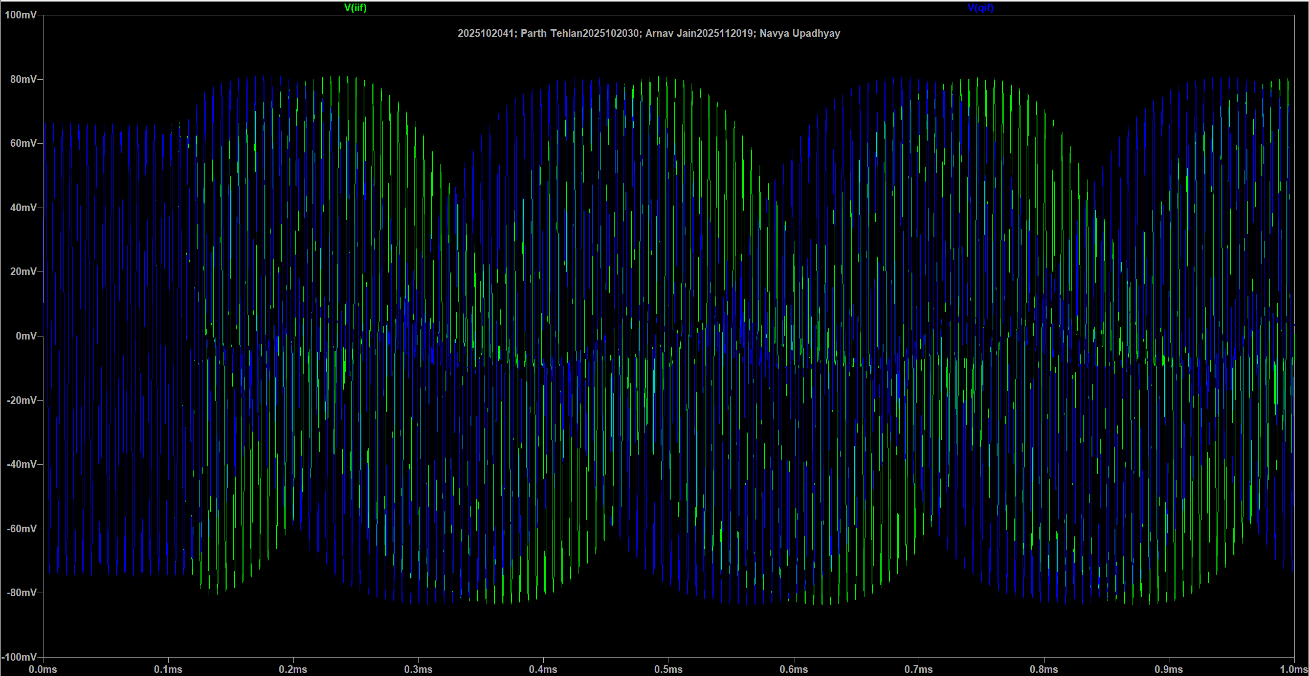
docs/images/ltspice_layouts/10_Transient_148kHz.png
