arnavwx/Analog-Quadrature-Down-Converter/docs/images/ltspice_layouts/11_FFT_148kHz.png

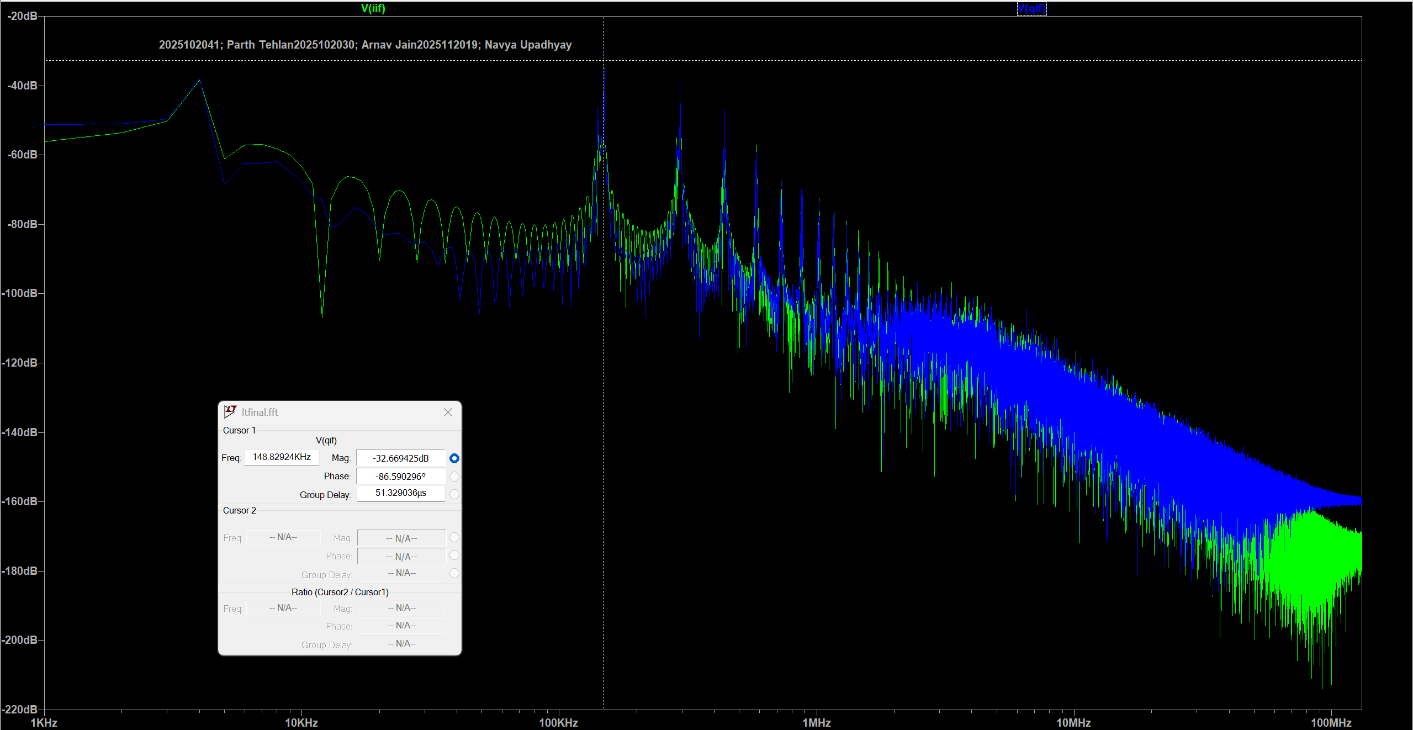
docs/images/ltspice_layouts/11_FFT_148kHz.png
