arnavwx/Analog-Quadrature-Down-Converter/docs/images/ltspice_layouts/12_Transient_149kHz.png

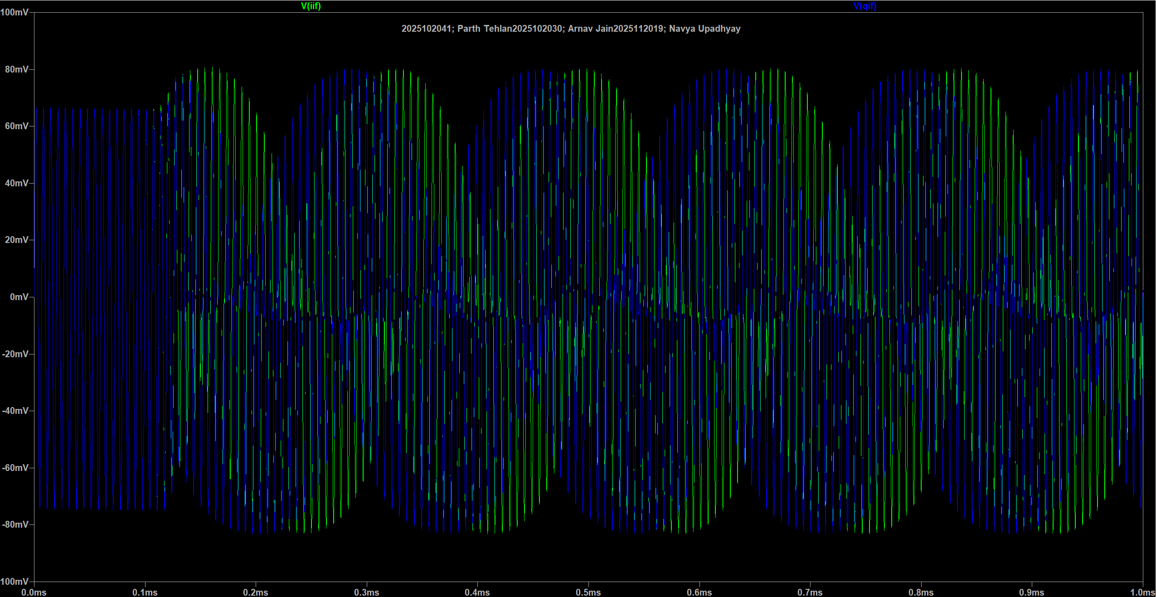
docs/images/ltspice_layouts/12_Transient_149kHz.png
