arnavwx/Analog-Quadrature-Down-Converter/docs/images/ltspice_layouts/13_FFT_149kHz.png

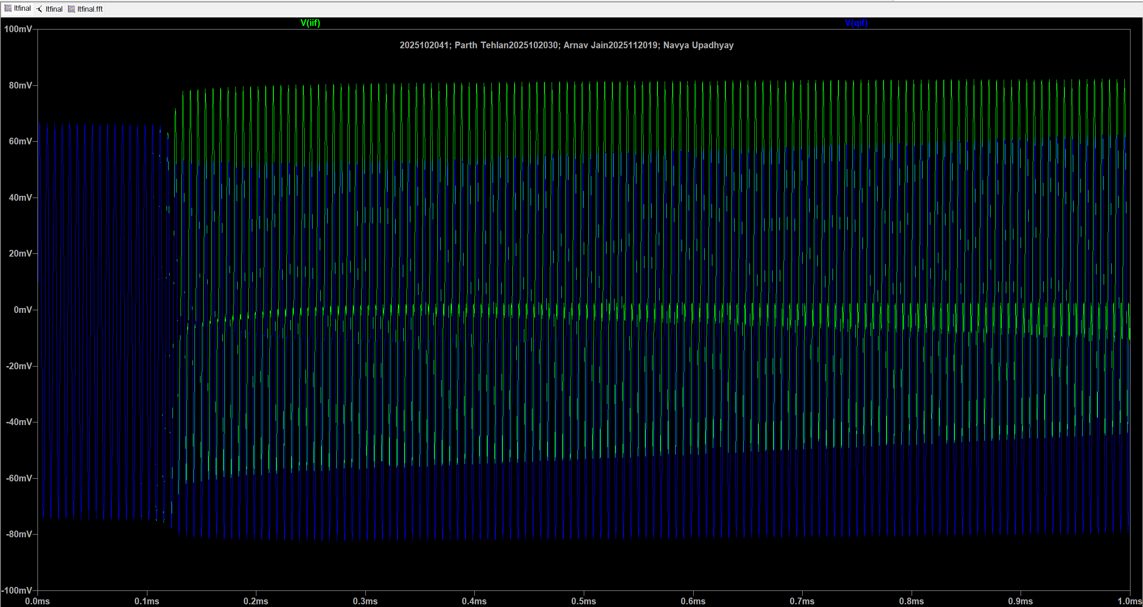
docs/images/ltspice_layouts/13_FFT_149kHz.png
