arnavwx/Analog-Quadrature-Down-Converter/docs/images/ltspice_layouts/14_Transient_151kHz.png

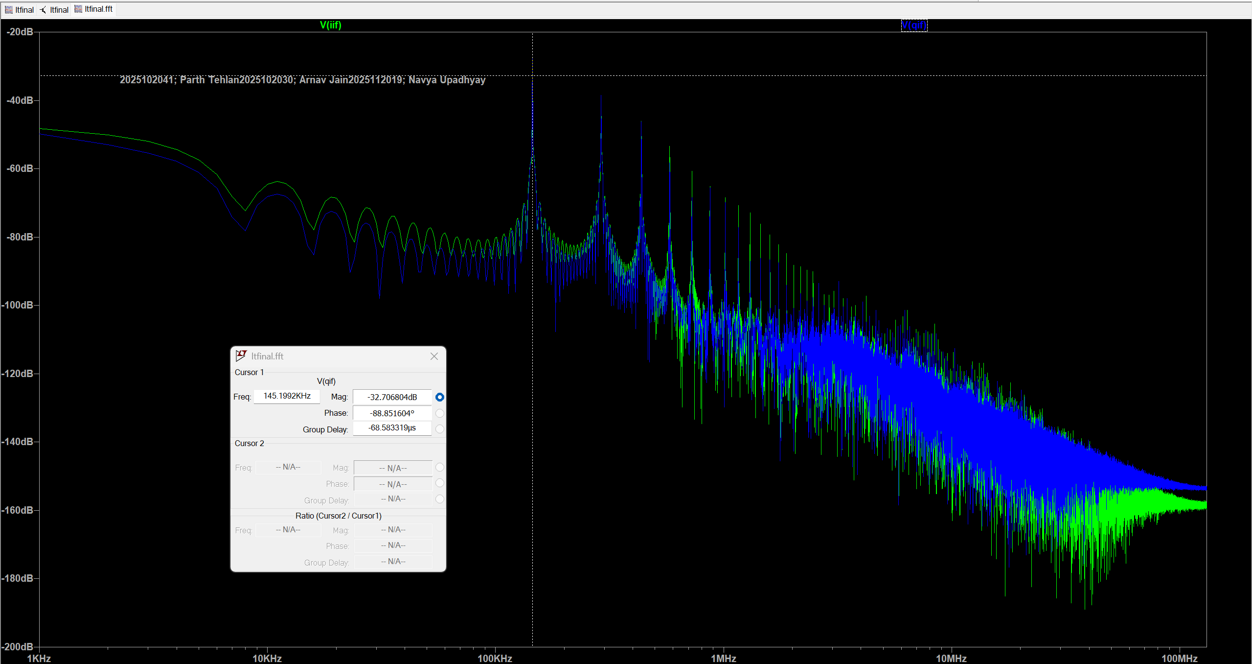
docs/images/ltspice_layouts/14_Transient_151kHz.png
