arnavwx/Analog-Quadrature-Down-Converter/docs/images/ltspice_layouts/15_FFT_151kHz.png

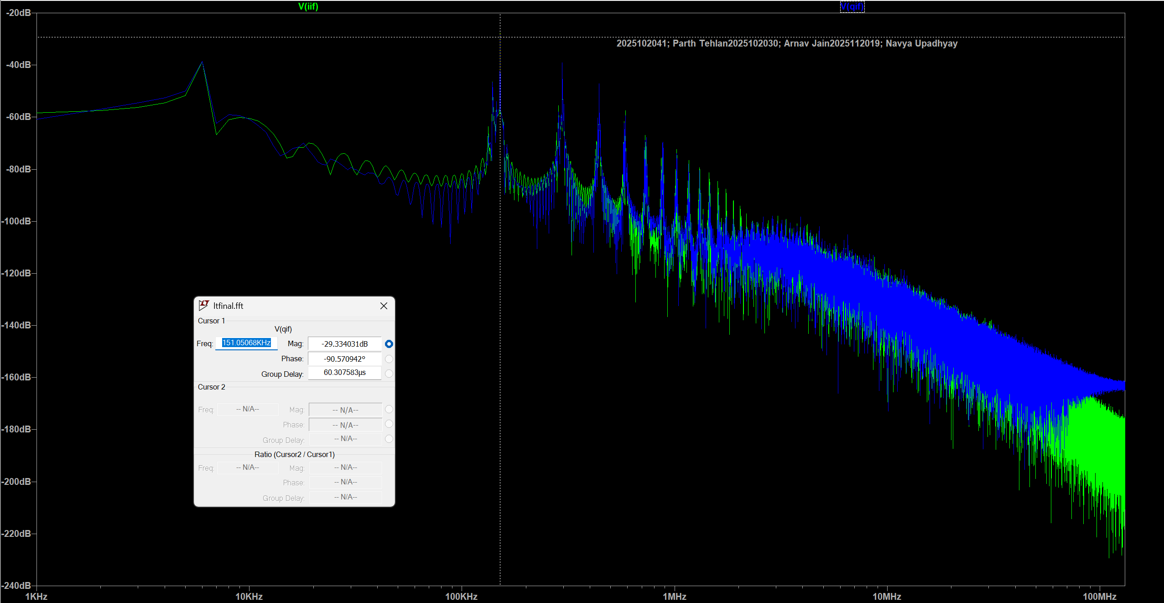
docs/images/ltspice_layouts/15_FFT_151kHz.png
