arnavwx/Analog-Quadrature-Down-Converter/docs/images/ltspice_layouts/19_FFT_155kHz.png

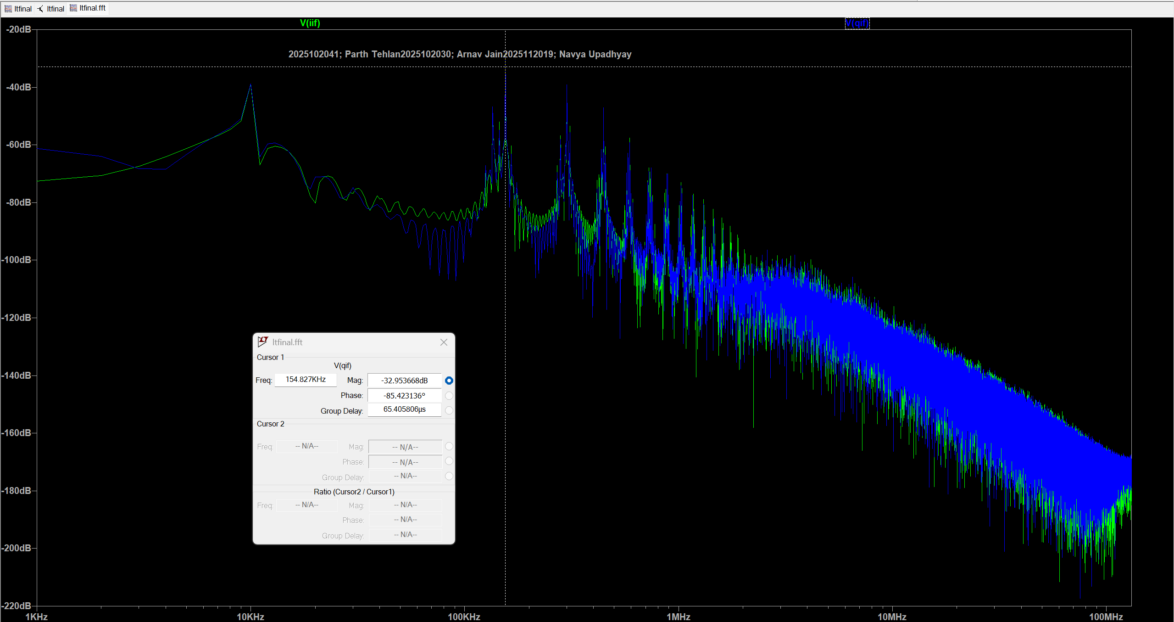
docs/images/ltspice_layouts/19_FFT_155kHz.png
