arnavwx/Analog-Quadrature-Down-Converter/docs/images/ltspice_layouts/21_LPF_Schematic.png

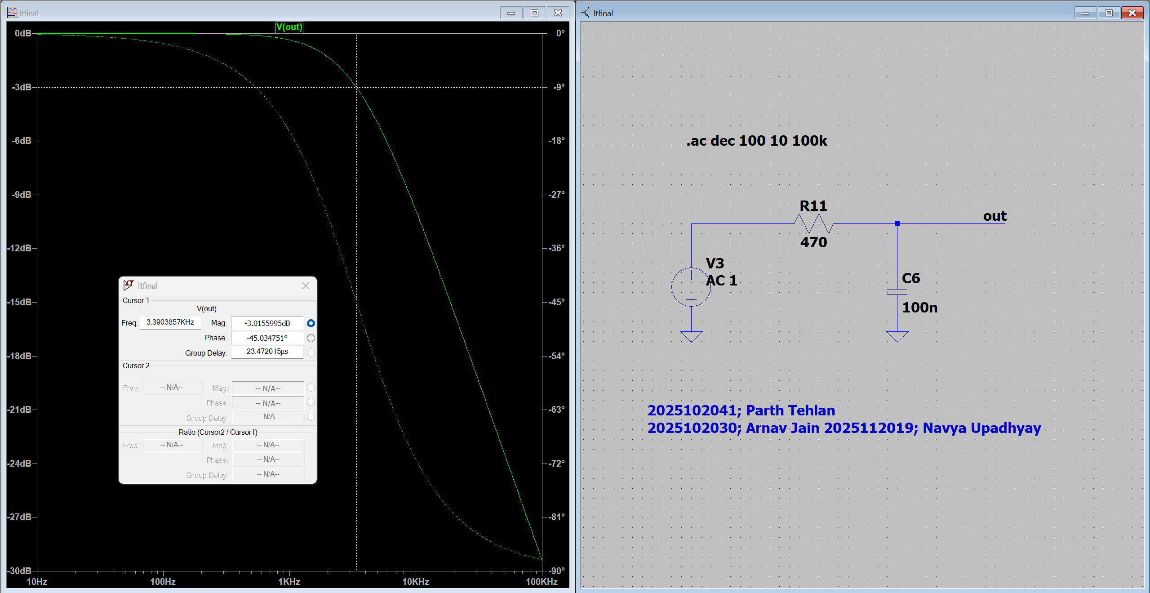
docs/images/ltspice_layouts/21_LPF_Schematic.png
