arnavwx/Analog-Quadrature-Down-Converter/docs/images/ltspice_layouts/27_Complete_Oscillator_Phase.png

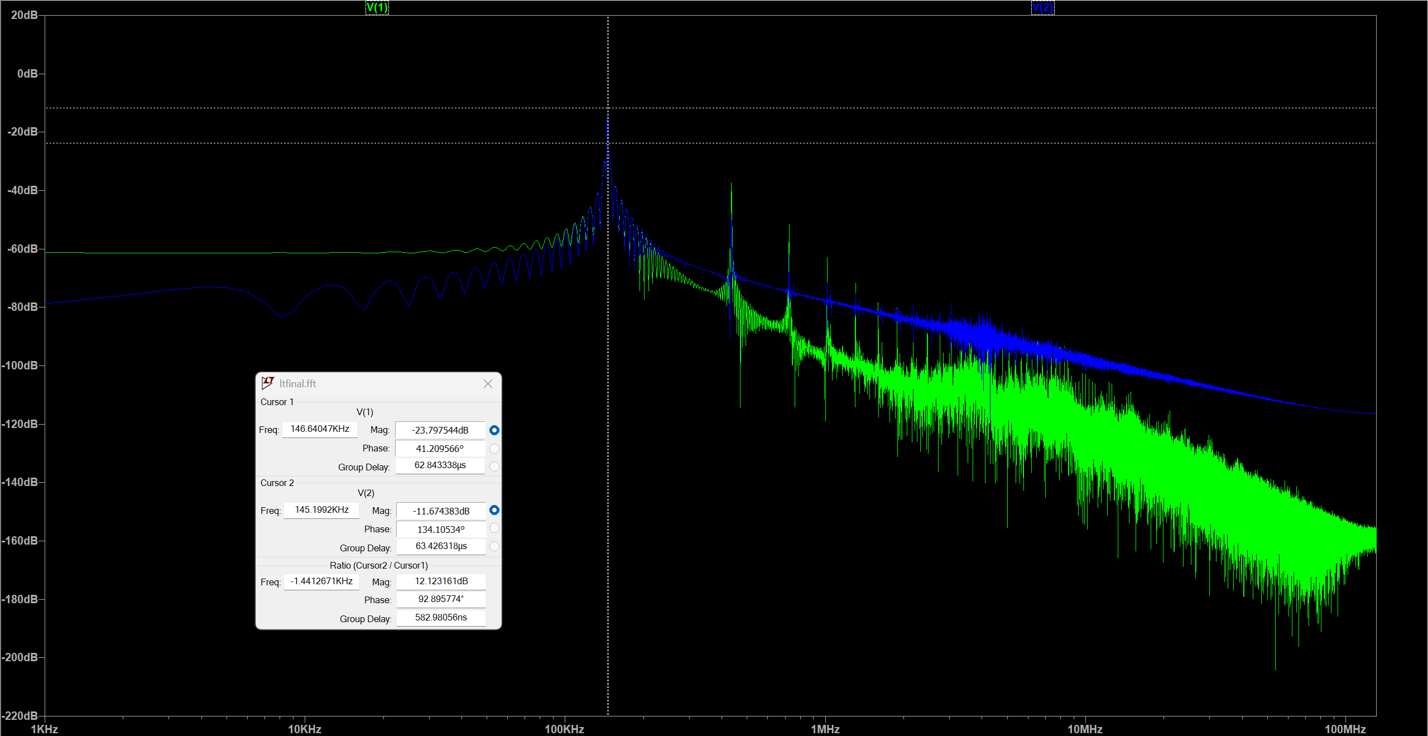
docs/images/ltspice_layouts/27_Complete_Oscillator_Phase.png
