arnavwx/Analog-Quadrature-Down-Converter/simulation/low_pass_filter.asc

C6: cap; 100n
R11: res; 470
V3: voltage; AC 1
Named nets: 0
.ac dec 100 10 100k
