arnavwx/Analog-Quadrature-Down-Converter/simulation/nmos_mixer.asc

Cc: cap; 1u
M1: nmos4; CMOSN
Rbias: res; 100k
RL: res; 1k
Vbias: voltage; 1
Vin: voltage; SINE(0 100m 150k)
Vosc: voltage; SINE(0 1 145k)
Named nets: 0
.tran 0 1m 0 10u
.inc TSMC_180nm.txt
.param width=10u
.model CMOSN NMOS (LEVEL=1)
