arnavwx/Analog-Quadrature-Down-Converter/simulation/qdc_complete.asc

C_LPF1: cap; 100n
C_LPF2: cap; 100n
M7: nmos4; CMOSN
M8: nmos4; CMOSN
M_AMP1: nmos4; CMOSN
M_AMP2: nmos4; CMOSN
R_LPF1: res; 470
R_LPF2: res; 470
U1: opamp2; UA741
U2: opamp2; UA741
.tran 0 1m 0 10u
.inc TSMC_180nm.txt
.inc UA741.301
.param width=10u
Complete Quadrature Down Converter
Integrates Oscillator, Mixer, LPF, and Amplifier
