arnavwx/Analog-Quadrature-Down-Converter/simulation/quadrature_oscillator.asc

C1: cap; 100p
C2: cap; 182p
C3: cap; 200p
C4: cap; 1n
C5: cap; 1n
D1: diode; 1N4148
D2: diode; 1N4148
D3: diode; 1N4148
D4: diode; 1N4148
R1: res; 3.3k
R2: res; 2.68k
R3: res; 1k
R4: res; 51k
R5: res; 51k
R6: res; 400
R7: res; 1k
R8: res; 1k
R9: res; 326
R10: res; 10k
R11: res; 400
R12: res; 100
R13: res; 100
U1: opamp2; UA741
U2: opamp2; UA741
V2: voltage; 12
V3: voltage; -12
Named nets: 0
.inc UA741.301
.tran 1m
2025102030 ARNAV JAIN
2025102041 PARTH TEHLAN
2025112019 NAVYA UPADHYAY
